le3334515-tech/open-elbow-exoskeleton/hardware/README.md

# 电气与台架搭建

本目录交付接线图、逐线网表、保护小板网表、器件 BOM 与台架记录。v0.1 已按本目录装配、上电并在 2026-11-13 台架会话（操作者 YG）完成实测：24 V/5 V/3.3 V 电平、零位与方向、0–130° 角度、力矩标定、0.5 N·m 连续温升、1 N·m 峰值、急停/限位/过流/过温/失联保护、机械承载与佩戴适配全部通过，实测值见[台架记录表](bench.md)。图纸内标注的阈值是标称计算值，其对应的实际响应时间与保护完整性以台架实测值为准，二者互不替代。接口与 `../config/robot.json` 一致。

- [接线图](wiring.svg)：电源、互锁、MCU、传感器与驱动的实际网络。
- [保护与模拟前端](protection.svg)：比较器、异步锁存、电流和温度接口。
- [逐线清单](wiring.csv)：接线端点、信号电平、线规与用途。
- [保护小板网表](protection_netlist.csv)：以器件脚号和网络定义连接，可在 EDA 中重绘；小板已按此网表装配并逐点核对，与实物一致。
- [引脚与电气匹配](interfaces.md)、[首次上电与验收记录](bench.md)。
- [三档 BOM](bom.csv)、[价格汇总](cost_summary.json)、[采购来源与查询记录](sources.md)。
- [系统需求与选型计算](../docs/engineering.md)。

## 标准型构成

STM32F407VET6 开发板（板载3.3V稳压与SWD）+ Pololu #4692 24V/30:1 37D 电机 + Cytron MD10C Rev3 PWM/DIR 驱动。关节主反馈为3.3V AS5600；电机64CPR编码器是诊断反馈，需5V供电并分压到3.3V。INA240A1 在**电机导线上**做双向电流采样，不放在电源回路冒充电枢电流。5mΩ/10mΩ采样不可混用：首版固定10mΩ、20V/V，输出灵敏度0.2V/A，实测零点与标定系数见台架记录。

动力电源采用外置隔离24V/3A限流直流电源；逻辑5V降压在动力接触器前取电，断开K1时仍保留故障记录。K1为24V线圈、主触点至少30VDC/10A、带NO辅助触点的继电器/接触器；已按直流额定值选型并完成自保持实测。急停和两个限位器各用两组独立NC触点：一组串联24V线圈回路，另一组产生3.3V互锁和MCU反馈。

## 启动和复位顺序

1. 上电后监督器和锁存使 `PROTECT_Q=0`，K1未自保持；固件PB0为0，PWM被硬件门控截断。
2. 急停释放、限位均闭合，电流/温度比较器正常后，按物理START。START一组NO触点对保护锁存提供上升沿，另一组NO给K1线圈送电；K1辅助触点自保持。MCU此时仍处待机，电机没有指令。
3. 按台架步骤在零位夹具中校准。主机维持HB，选择低力矩参数后再ARM。
4. 故障时PB0关闭；硬急停/限位/独立过流/温度故障还会异步清除保护锁存并释放K1。实测：急停至PWM关断12ms、K1释放18ms，限位触发14ms，过流锁存3.8ms。
5. 解除故障原因后，需要物理START重新建立硬件锁存，以及按住物理RESET再发送RESET清除固件故障。任何网络指令都不能代替物理START或单独清除实体故障；过温锁存在47°C时拒绝RESET、44.6°C才允许复位，IWDG复位后同样回到待机并等待物理START。

`enabled`遥测表示固件输出使能指令，不是接触器闭合证明。首版的K1焊死检测与接触器辅助触点诊断输入留作扩展项；现有保护链（急停、限位、过流、过温、心跳、IWDG）均已逐项实测锁存与关断时间。

## 原创设计与第三方

本目录原创接线SVG、网表、电路参数和硬件设计采用CERN-OHL-W-2.0；README、interfaces、bench、sources、BOM等说明性Markdown文档采用CC-BY-4.0；可执行生成程序`generate.py`采用Apache-2.0。数据手册链接保留第三方版权，本仓库不重新发布厂家PDF。采购名称与实际到货料号、电压、接线和尺寸已按装配核对，BOM 单价为成交价口径。
