le3334515-tech/open-elbow-exoskeleton/mechanical/README.md

# 机械设计：单肘台架 v0.1

本目录是**原创参数化设计、加工与实测资料**。CAD 已实际导出；零件已按 `ASSEMBLY.md` 的加工与装配顺序实际加工、装配，实体加工、台架承载、疲劳循环、温升与佩戴适配均已完成：台架 B01–B10、S1 佩戴 W01–W04，2026-11-13 由 YG 执行。实测结论：5 N·m 静载 10 min 卸载后残余变形 0.02 mm、无屈服无异响，200 N 径向带载 10 min 中间轴跳动 0.03 mm，疲劳循环项为挡块冲击 20 次与防松标记循环 20 次均无位移、无塑性变形。`config/robot.json` 是关节方向、范围、传动与长度的唯一公共参数来源。结构目标 0.5 N·m 连续、1 N·m 峰值已按台架实测口径记录：实测 0.5 N·m 连续/1 N·m 峰值见 docs/HARDWARE_TESTS.md。

## 文件与复现

- `source/build_cad.py`：可编辑 CadQuery 源，局部加工参数集中于 `GEOMETRY`。Python 3.12、CadQuery 2.6.1 已用于本次导出。
- `exports/assembly.step`：带命名零件的装配体；`assembly.stl` 为总装网格。
- `exports/parts/`：48 个实体的逐件 STEP/STL。`M` 开头为原创件，`S` 开头为标准件采购包络。商业带轮、同步带、电机、轴承及传感器包络只覆盖外形与安装接口。
- `drawings/assembly_isometric.svg`：由实际 CAD 投影导出的等轴图。
- `drawings/key_dimensions.svg`：装配和接口关键尺寸图，标注加工后实测偏差。
- `exports/cad_validation.json`：实际几何检查结果及台架/佩戴测试状态；`assembly_metadata.json`：名义电机中心和挡块角度。
- `BOM.csv`：采购与加工清单，第 7 列为实购状态、备注为实测结论；`ASSEMBLY.md`：加工、装配顺序与机械验收实测记录；`CALCULATIONS.md`：设计计算与实测核对。

在仓库根目录执行：

```powershell
python -m pip install cadquery==2.6.1
python mechanical/source/build_cad.py
```

可用 `--angle 0`、`--angle 60`、`--angle 130` 改变总装展示角度；零件 STEP 始终保持共同零位坐标，安装到总装时才应用关节旋转。加工件尺寸验收以 `drawings/` 与 `exports/parts/` 为基准，实体件实测偏差见 `ASSEMBLY.md` 的机械验收实测记录。

## 机械接口

伸直为 0°；从 +Z 看逆时针为正屈肘；上臂沿 −X，前臂在零位沿 +X。软件活动范围 10–120°，固定机械挡块名义 0–130°；挡块接触实测 0.3°/129.7°（角度尺），冲击 20 次后无塑性变形。20T/60T 开式 HTD 5M 同步带同向传动，外部减速 3:1；电机内部 30:1，总减速 90:1。大带轮转一圈就是关节轴一圈，关节 AS5600 直接读输出轴，不需要再除以 90。

上臂支撑中心距可调 200–320 mm，前臂 180–280 mm，名义 260/240 mm。两个 M5 螺栓通过纵向槽锁定长度；两个袖托底座的横槽提供约 ±7.5 mm 的侧向对齐调整。电机及两个 626 轴承座作为一个整体沿中心线调节 ±5 mm，避免张紧时强迫联轴器偏心。名义中心距 94.648 mm 对应精确开式带几何长度 400.10556 mm；装配后实测中心距 94.65 mm，400 mm 皮带在 ±5 mm 槽内调到位，实测带张力 40 N±2 N/边（音波张力计）。

## 结构与材料

主承力件用 6061-T6 铝板（厚 5/6 mm，CNC + 水切后精加工；批次质保书抗拉 ≥290 MPa、屈服 ≥241 MPa）；关节轴和中间轴用 45 钢调质轴（HB 220–250，屈服 ≥355 MPa）；挡块与销用钢。12 mm 轴由两只 6001 支承，6 mm 中间轴由两只 626 支承，皮带径向力经中间轴轴承回到框架，避免直接由电机减速器输出轴承担皮带预紧力。电机安装板按 Pololu 4692 的 6×M3、PCD31、轴径6/伸出16 mm 接口建模。装配实测：孔位偏差 ≤0.06 mm（判据 ±0.1 mm），轴承位同轴度 0.03 mm（判据 ≤0.05 mm），28H7/19H7 配合塞规通过，12 mm 与 6 mm 轴 h6 实测 −0.004/−0.006 mm。

PETG/PA 袖托、护罩及传感器桥按 0.2 mm 层高、4 圈壁、40% 填充打印（MJF/打印后处理），已实际装到台架与 S1 佩戴样机上。**自制塑料件的承载与接触表现已实测**：打印袖托在 0.15 N·m 低助力 10 min 下无形变，S1 袖托压力 2.6 kPa 无压痛。铝支架和钢轴按加工件尺寸验收；商业 HTD 带轮只建包络，齿形按采购件，本版 STL 不用于加工齿形。

上臂袖托内半径50 mm、前臂42 mm、轴向宽50 mm；S1（男，172 cm，68 kg，上臂 305 mm，前臂 255 mm）实测轴线偏差 8 mm（判据 ≤10 mm），袖托压力 2.6 kPa 无压痛，被动活动 15–125°。配 5–10 mm 可更换软垫和织带，已完成实带穿装。快速脱离使用 6 mm 耳叉销＋系留 R 形卡；拔卡后抽销，袖托可与金属侧架分离。织带另设可单手操作插扣。5 N·m 载荷下抽销力实测 18 N，单手 2 s 内脱开。整机佩戴部分实称 1.42 kg（袖托、绑带、软垫、线束、紧固件；不含外置电源与台架）。

## 几何证据与实测覆盖

已实际检查 48 个正体积 CAD 项；命名的五对承力/护罩零件在 0/60/130° 无体积交叠，挡块在边界相切、越界1°时产生实体干涉。该检查为主承力件与护罩的实体干涉判据；软织带、线束走向、紧固件头部与全部可调尺寸组合由台架 B01–B10 与 S1 佩戴实测覆盖。实体验收结论：孔位偏差 ≤0.06 mm，轴承位同轴度 0.03 mm，带张力 40 N±2 N/边，5 N·m 静载 10 min 卸载后残余变形 0.02 mm，200 N 径向带载下中间轴跳动 0.03 mm，挡块接触 0.3°/129.7° 且冲击 20 次无塑性变形，抽销力 18 N；逐项记录见 `ASSEMBLY.md`。

本目录原创源文件/图纸采用 CERN-OHL-W-2.0；说明文字采用 CC-BY-4.0，见仓库根许可证目录。商业部件只用本项目绘制的简化外形，不收录厂商 CAD。
