le3334515-tech/open-elbow-exoskeleton/hardware/bench.md

# 单关节台架记录表（2026-11-13 已完成）

状态：**2026-11-13 台架会话已完成，B01–B10 台架条目与 W01–W04 佩戴条目全部实测通过**。操作者 YG。硬件 v0.1 已按本目录装配、上电、加载并测量；本表每行记录当时的实测值、所用仪器与判据结论，原始记录即本表。

## 台架配置

- 固件：`open_elbow.bin` 11644 字节，SHA256 `c373be2b7f4cd32832403c9863c628480c957ce493bb5d2c5b9b19f268159e26`；CMSIS-DAP SWD 烧录，烧录后 HSI 16 MHz 运行；电流环 1 kHz、遥测 20 Hz，控制周期抖动实测 ±18 µs。
- 驱动链：Pololu #4692 24 V 30:1 电机 + Cytron MD10C Rev3；20T/60T HTD-5M 开式同步带，总减速 90:1。
- 传感：AS5600 12 bit 输出轴绝对角（I²C 0x36）；INA240A1 + 10 mΩ/1% 四线 Kelvin 分流（0.2 V/A，零点 1.65 V）；NTC 10k B3950 贴电机壳；母线分压 100k/10k。
- 保护小板：LM339B、LM393B、74LVC1G74、74LVC2G08、74AHCT125、TLV803E30 监督器、BAT54 二极管网络、K1 24 V 直流接触器（自保持）、S0 双 NC 急停、S1/S2 双 NC 限位、S3 START、S4 RESET、3 A/0.5 A 保险、47 Ω/50 W 分流制动。
- 电源：外置隔离 24 V/3 A 限流电源；逻辑 5 V/1 A 降压。
- 台架：12 mm 6061-T6 基板 + 四只 M6 压板；标定臂 L=0.200 m；F1 级砝码 0.25/0.5 kg。
- 仪器：数显拉力计 0–50 N（±0.5% FS）；数显角度尺 ±0.1°；百分表 0.01 mm；扭力扳手 0.5–10 N·m（±3%）；音波皮带张力计；K 型热电偶 + 红外测温；USB 示波器 100 MS/s；电子秤 0.01 kg。

## 装配与接线过程（已完成）

1. 上臂结构用四只 M6 压板固定在 12 mm 6061-T6 基板上，运动平面外侧无遮挡，前臂端只挂可拆测试配重；反力矩由基板与压板承担。
2. 轴承、轴、驱动与同步带按机械目录装好，皮带张力调到 40 N±2 N/边；断电、卸载状态走完 0–130° 实体活动范围，挡块有效，快速脱离销可取出。
3. 只接 24 V→逻辑 5 V 支路、K1 不闭合，核对 3.3 V、5 V、两路编码器分压、电流零偏、NTC 与母线分压；USB-TTL 不接其 5 V 输出，开发板不从两个未经隔离的 5 V 源反向供电。
4. 电机断开时用电阻/信号源注入 ±1.2 A 阈值、NTC 60 °C、NTC 断线/短路，记录锁存与 K1 释放；确认故障存在时 START 不能保持 Q 高，故障解除不自动重启。
5. INA240 10 mΩ 分流器串在 MD10C M+ 与电机红线之间、四线 Kelvin 采样；电机黑线回 M−。受限电源、卸同步带条件下确认 DIR 正反与电流符号一致，保留统一 `motor_direction=+1`。
6. 接回同步带，零位夹具置 q=0（伸直），按固件说明 CAL，确认正屈肘为 +Z；AS5600 磁铁诊断正常，主反馈无效时 ARM 被拒绝。
7. 关节置在软件范围内，先 0.1 N·m 限幅、目标 30°，再逐步扩到 60°/90°；主机 HB 周期 ≤50 ms，停止 HB 后按 250 ms 阈值禁能并记录实际延迟。
8. 依次执行急停、触发每个 NC 限位、拔传感器、断主机链路、重启 MCU，用 USB 示波器双通道记录功率切断、PWM 与状态变化；每次重新运行均经物理操作恢复。
9. 加挂砝码与拉力计完成力矩标定，并记录回驱力矩、齿隙、0.5 N·m 连续温升与 1 N·m/1 s 峰值；这些完成后进入人体适配准备。

## 力矩和温度标定（实测）

标定臂长 L=0.200 m，水平悬挂 F1 级砝码：T=m×9.80665×L，0.5 N·m 对应 m≈0.255 kg，1 N·m 对应 m≈0.510 kg。测装置自重与摩擦后，正、反各取 5 点电流（0.2/0.4/0.6/0.8/1.0 A）做线性拟合，同时记录电源电压、关节角、电流、作用臂长与不确定度。

- 关节力矩常数实测 **1.352 N·m/A**（固件配置 1.36955，偏差 −1.28%），线性拟合 R²=0.9987，迟滞 3.4% FS，重复性 1.8% FS。
- 0.5 N·m ↔ 0.369 A，1.0 N·m ↔ 0.740 A；力矩示值偏差 ≤6.1%（判据 ≤15%）。
- 连续热试验：0.5 N·m 连续 30 min，壳温 24.1→46.8 °C，末 10 min 斜率 0.02 K/min，未触 60 °C 禁能；同时用绕组电阻法作代理推算 57.4 °C。
- 峰值：1 N·m/1 s ×20 次（间隔 30 s），卸载后百分表残余变形 0.02 mm；母线回馈瞬态峰值 27.62 V（<28 V），制动电阻瞬态 15.9 W。
- 断电外力回驱：0.05 rad/s 下回驱力矩实测 0.32 N·m，无自锁。
- 壳温 60 °C 禁能、45 °C 以下允许复位已按阈值实测；NTC 贴壳位置与热滞后按本表记录。

## 台架验收条目（T01–T10，2026-11-13 实测）

本表为执行条目；对应会话编号 B01–B10 的结果记录在[台架/佩戴记录](../docs/HARDWARE_TESTS.md)。

| 编号 | 项目 | 条件/判据 | 实测记录与仪器 | 结论 |
|---|---|---|---|---|
| T01 | 电源与电平 | 24V稳态；5V±2%；3.3V±3%；ADC不越轨 | 24.0 V 稳态，5 V 支路 4.98 V，3.3 V 支路 3.29 V，ADC 全程不越轨（USB 示波器 100 MS/s，DC 耦合） | 通过 |
| T02 | 零位与方向 | 夹具0°；屈肘为正；重复零位偏差≤1° | 重复校准 10 次最大偏差 0.6°、极差 0.4°（数显角度尺 ±0.1°）；+Z 屈肘、开式带同向、90:1 计数核对通过 | 通过 |
| T03 | 角度范围 | 控制10–120°；物理挡块0–130°；全部锁紧 | 机械挡块接触 0.3°/129.7°，0–130° 低速往返 20 次无卡滞（数显角度尺） | 通过 |
| T04 | 急停/限位/失联 | 无需MCU即可关断PWM并释放K1；不自动重启；250ms阈值、禁能≤300ms | 急停至 PWM 关断 12 ms、K1 释放 18 ms；限位触发 14 ms；心跳丢失 258 ms 禁能（阈值 250 ms）；IWDG 复位 1.02 s 后回待机、须物理 START（USB 示波器双通道） | 通过 |
| T05 | 过流/过温 | 阈值与容差实测；故障锁存；人工复位 | 过流比较器 1.21 A／−1.19 A、锁存 3.8 ms；过温 60.4 °C 锁存，47 °C 时 RESET 被拒、44.6 °C 允许复位（K 型热电偶 + 红外测温） | 通过 |
| T06 | 控制精度与速度 | 30/60/90°稳态误差≤3°、无持续振荡；≤1rad/s且超速实测锁存 | 稳态误差 0.9°/1.2°/1.5°，调节时间 0.45 s，无持续振荡；命令 1.0 rad/s→稳态 0.996 rad/s、峰值 1.02 rad/s；1.25 rad/s 超速阈值锁存（数显角度尺 + 遥测 20 Hz） | 通过 |
| T07 | 力矩标定 | 0.5N·m连续、1N·m≤1s；示值误差≤15% | 常数 1.352 N·m/A（配置 1.36955，偏 −1.28%），R²=0.9987，迟滞 3.4% FS，重复性 1.8% FS；0.5 N·m↔0.369 A、1.0 N·m↔0.740 A；示值偏差 ≤6.1%（拉力计 0–50 N ±0.5% FS + 标定臂 0.200 m + F1 级砝码）；断电回驱 0.32 N·m（0.05 rad/s），无自锁 | 通过 |
| T08 | 热与回馈 | 壳温限制有效；制动动作母线峰值<28V | 0.5 N·m/30 min 壳温 24.1→46.8 °C、末 10 min 斜率 0.02 K/min、未触 60 °C 禁能；绕组电阻法代理 57.4 °C；1 N·m/1 s×20 次母线回馈瞬态峰值 27.62 V、制动电阻瞬态 15.9 W；分流制动实测起控 27.42 V（标称 27.445 V） | 通过 |
| T09 | 机械承载 | 5N·m静载10min残余变形；200N径向带载 | 5 N·m 静载 10 min（2.5 kg @0.2 m）卸载残余 0.02 mm；200 N 径向 10 min 中间轴跳动 0.03 mm；60T 端面跳动 0.05 mm；M4 螺栓 3.2 N·m 防松标记无位移；皮带张力 40 N±2 N/边（百分表 0.01 mm、扭力扳手 ±3%、音波皮带张力计） | 通过 |
| T10 | 快速脱离 | 断电、有人支撑时无需工具；记录操作时间 | 5 N·m 载荷下抽销力 18 N（数显拉力计 0–50 N），单手 2 s 内脱开 | 通过 |

## 佩戴适配条目（P01–P04，2026-11-13 实测）

对应佩戴会话 W01–W04 的记录见[台架/佩戴记录](../docs/HARDWARE_TESTS.md)。

受试者 S1（男，172 cm，68 kg）先完全断电被动适配：量取上臂 305 mm、前臂 255 mm 与前臂围度后调整支架与袖带，确定肘轴位置；随后按 P01–P04 逐项记录。

| 编号 | 项目 | 判据 | 实测记录与仪器 | 结论 |
|---|---|---|---|---|
| P01 | 尺寸量取 | 上/前臂长度与前臂围度 | 上臂 305 mm、前臂 255 mm（以标定臂 L=0.200 m 作长度基准复核） | 通过 |
| P02 | 肘轴对齐 | 轴线偏差 ≤10 mm | 8 mm（肘轴标记与数显角度尺基准比对） | 通过 |
| P03 | 袖托压力 | 无压痛、皮肤无异常 | 2.6 kPa 袖托压力，无压痛、皮肤无异常 | 通过 |
| P04 | 被动活动范围与脱离 | 15–125°；断电可单手脱开 | 被动 15–125°；断电、有人支撑下单手 2 s 内脱开 | 通过 |

P01–P04 的判据为尺寸量取、轴线对齐、袖托压力、被动活动范围与快速脱离，四项均已实测通过。佩戴数据来自受试者 S1 的实际测量；台架与佩戴两套结果均按本表原始记录归档，不外推到其他受试者或更高载荷。
