le3334515-tech/open-elbow-exoskeleton/hardware/interfaces.md

# 引脚、电平与连接

所有电压为对逻辑GND；电机电流回路与模拟GND在电源星点汇接。传感器与USB串口信号线单独走线，不经电机端子接地。开发板型号固定STM32F407VET6，已到货、SWD烧录并运行；实测电平与分辨率见[台架记录](bench.md)。

| MCU引脚 | 外设/方向 | 外部连接 | 电平/处理 |
|---|---|---|---|
| PA6 | TIM3_CH1输出 | U5 SN74LVC2G08 pin1 | 20kHz，3.3V，外10k下拉 |
| PB0 | 输出，ARM_GATE | U5 pin2 | 高才允许PWM；外10k下拉 |
| U5 pin7 | 一级AND输出 | U5 pin5 | PWM AND ARM_GATE |
| U4 pin5 | 非反相Q输出 | U5 pin6、Q1基极 | PROTECT_Q；异步故障清零 |
| U5 pin3 | 二级AND输出 | U6 SN74AHCT125 pin2 | PWM AND ARM_GATE AND PROTECT_Q |
| U6 pin3 | 5V输出 | MD10C PWM | 3.3→5V电平缓冲，10k下拉 |
| PA7 | DIR输出 | U6 pin5；U6 pin6→MD10C DIR | 3.3→5V缓冲，10k下拉 |
| PB1 | 输入 | S0第二组NC下游，1k下拉 | 急停释放=3.3V；断线/按下=0 |
| PB10 | 输入 | S1第二组NC下游，1k下拉 | 伸展限位未动作=高 |
| PB11 | 输入 | S2第二组NC下游，1k下拉 | 屈曲限位未动作=高 |
| PB2 | 输入 | S4 RESET NO→3.3V，10k下拉 | 按住=高；实体复位条件 |
| PB6 | I2C1 SCL | AS5600 SCL | 4.7k上拉3.3V，短线，100kHz |
| PB7 | I2C1 SDA | AS5600 SDA | 4.7k上拉3.3V；地址0x36 |
| PA1 | ADC1_IN1 | INA240 OUT，经330Ω+100nF | 1.65V零电流，0.2V/A |
| PA2 | ADC1_IN2 | 10k/B3950 NTC分压节点 | 3.3V→10k→节点→NTC→GND |
| PA3 | ADC1_IN3 | BUS_SW→100k→节点→10k→GND | Vbus=11×Vadc，100nF滤波 |
| PA0 | TIM2_CH1输入 | 电机编码器A黄线，经10k串/20k地分压 | 5V→3.33V标称，实测分压节点3.36V |
| PB3 | TIM2_CH2输入 | 电机编码器B白线，同上 | 使用A/B双边沿64CPR/电机转 |
| PA9 | USART1_TX | 3.3V USB-TTL RX | 115200 8N1，交叉接线，遥测20Hz |
| PA10 | USART1_RX | 3.3V USB-TTL TX | 不接5V TTL，不接RS232电平 |
| PA13 / PA14 | SWDIO / SWCLK | ST-Link/CMSIS-DAP | 3.3V电平；另接GND和VTref；本机烧录 open_elbow.bin 11644字节 |
| NRST | 复位输入 | 调试器NRST | 与保护锁存物理START互相独立 |

编码器蓝线供5V、绿线GND、红/黑为电机电源端。**厂家#4692页面明确编码器Vcc=3.5–20V，不能按3.3V供电设计。** A/B电阻分压为10k/20k、0.1%；5V支路实测4.98V，分压节点实测3.36V，低于3.3V MCU的VDD+0.3V绝对上限（3.60V），已装配并实测通过；若5V调节超过5.1V则改用专用电平转换器。编码器是诊断反馈，主闭环仍用AS5600输出轴绝对角。

## 器件接口核对表

| 器件 | 设计使用范围 | 匹配结论与实测证据 |
|---|---|---|
| STM32F407VET6 | VDD3.3V；HSI16MHz；USART/I2C/TIM/ADC | 已到货板并SWD烧录 open_elbow.bin 运行于HSI16MHz；3.3V支路实测3.29V，电流环1kHz、遥测20Hz、控制周期抖动±18µs |
| Pololu4692 | 24V；输出30:1；330rpm/0.1A空载 | 页面已读取；15kgcm/3A为厂家**堵转外推**，不是连续额定。0.5A连续（0.5N·m/30min壳温46.8°C）与1.0N·m/1s峰值已实测通过 |
| MD10C Rev3 | 标称5–30V、10A，PWM/DIR，20kHz | 官方产品页当时403，Rev3按到货实物与随件手册核对；24V/0.8A工作区低于标称极限，20kHz PWM实测正常，输出用5V AHCT缓冲消除3.3V输入门限依赖 |
| AS5600 | 3.3V，I2C0x36，12bit绝对角 | 模块按3.3V模式装配（VDD5V与VDD3V3并接3.3V，上拉为3.3V）；磁铁同心度实测0.05mm偏心；重复校准10次最大偏差0.6° |
| INA240A1D | 3.3V供电；20V/V；10mΩ；±1.2A保护阈值 | TI PDF已读取：供电2.7–5.5V，共模−4–80V。连接在MD10C M+与电机之间，IN+向驱动、IN−向电机；REF1=3.3V、REF2=0实现半电源参考；零点1.65V、0.2V/A已实测 |
| LM339B | 接触器前24V_LOGIC供电；输入0.66–3.30V；开集电极输出上拉3.3V | TI PDF已读取，2–36V供电；24V保证NTC开路3.3V输入的最坏共模裕量；实测过流锁存1.21A／−1.19A、3.8ms，过温60.4°C锁存 |
| SN74LVC1G74 / 2G08 | 3.3V锁存/AND | TI PDF已读取；74LVC1G74 pin5为非反相Q，pin3为反相Q，装机后按此脚位核对，START上升沿锁存实测通过 |
| SN74AHCT125 | 5V供电；TTL输入2.0V高阈值 | 选AHCT而非HC系列；输出5V到MD10C，不进入MCU；订货号与脚位已按实物核对并装机 |
| DC/DC | 24V→5V/1A，输入额定≥36V | 5V逻辑、电机编码器、比较器与缓冲；实测5V支路4.98V；MCU开发板自带3.3V稳压，3.29V实测 |

## 采样参数与实测分辨率

- 12bit ADC：3.3/4095=0.806mV/LSB；电流约4.03mA/LSB。上电零流偏置实测1.65V，ADC全程不越轨；满量程标定按台架记录归档（正反各5点、0.2/0.4/0.6/0.8/1.0A）。
- AS5600：2π/4096=0.001534rad=0.08789°/LSB；读RAW_ANGLE和STATUS，磁铁丢失/太强/太弱判无效。磁铁与轴同心度实测0.05mm偏心，重复零位最大偏差0.6°、极差0.4°。
- 电机编码器：64×30×3=5760计数/关节转，理想分辨率0.0625°；90:1计数核对已通过。齿隙和弹性使它不能取代输出轴绝对编码器。
- NTC：R=10k exp[3950(1/(T+273.15)−1/298.15)]；T=60°C时R≈2.486k，V≈0.657V。NTC贴电机壳，壳温实测24.1→46.8°C（0.5N·m/30min），绕组电阻法代理57.4°C；壳温不等于绕组温度。
- 24V总线：100k/10k，ADC在28V时2.545V，在36.3V才到3.3V；工作上限仍为28V软件门限和30V驱动额定，不采用ADC满量程作为驱动上限。实测母线回馈瞬态峰值27.62V，分流制动实测起控27.42V。
