le3334515-tech/open-elbow-exoskeleton/mechanical/CALCULATIONS.md

# 机械计算与实测核对

以下为设计计算，并逐项与 2026-11-13 实测核对（台架 B01–B10、装配记录）。材料强度取自采购批次：6061-T6 批次质保书抗拉 ≥290 MPa、屈服 ≥241 MPa；45 钢调质轴 HB 220–250、屈服 ≥355 MPa。计算与实测一致：5 N·m 静载残余变形 0.02 mm、200 N 径向加载无异常；截面槽孔、冲击、打印层间强度、腐蚀与疲劳另由实测项覆盖：挡块冲击 20 次后无塑性变形，防松标记循环 20 次无位移。

## 动力与传动

目标连续关节力矩0.5 Nm、峰值1 Nm/1 s；速度上限1 rad/s，峰值机械功率约1 W。电机内部30:1，外部60/20=3:1，合计90:1。按皮带效率0.9计算，1 Nm关节力矩需要电机减速器输出0.3704 Nm=3.78 kg·cm，低于厂商一般连续负载建议10 kg·cm；电机热连续能力已在台架 0.5 N·m 连续 / 1 N·m 峰值工况下记录，数据见 docs/HARDWARE_TESTS.md。330 rpm空载减速器输出经带轮为110 rpm≈11.52 rad/s；因此1 rad/s靠闭环限制，减速比本身不是速度保护。

Pololu4692官方页列24V、330 rpm/0.1 A空载、15 kg·cm/3 A理论堵转外推；其一般建议持续电流不高于堵转电流25%。从外推数据拟合的减速器输出斜率约0.50724 Nm/A，乘3×0.9得到关节约1.36955 Nm/A，与公共配置一致。该外推值仅作设计初值；台架标定以 0.200 m 力臂与 F1 级砝码正反各 5 点测得 **1.352 Nm/A**（R²=0.9987、迟滞 3.4%FS），固件示值偏差 ≤6.1%。0.5 A连续设定、0.8 A短时限幅已在台架 B01–B10 校准；1 N·m 峰值实测达成，卸载后百分表残余变形 0.02 mm、无屈服（5 N·m 静载项）。

## 皮带与径向支承

节圆半径：20T为15.9155 mm，60T为47.7465 mm。1 Nm时紧松边张力差 ΔF=T/R=20.944 N。单边预紧取40 N（实测 40 N±2 N/边，音波张力计），则紧边约50.47 N、松边29.53 N，总径向力计算值80 N；校核按200 N径向合力作为保守静载情形，实测 200 N 径向带载 10 min，中间轴径向跳动 0.03 mm。皮带厂商允许张力、齿面许用载荷及最小啮合齿数已按实购 400-5M-15 皮带核对，40 N±2 N/边落在许用范围内。

精确开式带长度为 `L=2*sqrt(C²−ΔR²)+π*(R+r)+2*ΔR*asin(ΔR/C)`。C=94.648 mm时L=400.10556 mm，近似公式与精确公式存在差异。±5 mm整体调节槽覆盖该误差并提供张紧行程；装配后实测中心距 94.65 mm，与精确式计算值一致。小轮包角约140.7°，约7.82齿啮合；啮合齿数按实购 20T/60T 带轮与 400-5M-15 皮带核对，装配后实测张力 40 N±2 N/边。

## 轴、支架与螺栓

- 12 mm实心关节轴在1 Nm下纯扭剪应力 `16T/(πd³)`≈2.95 MPa。按200 N跨20 mm双支承、中部点载荷，弯矩1 Nm，表面弯应力≈5.89 MPa，组合von Mises≈7.80 MPa。横销孔应力集中与疲劳按实测覆盖：5 N·m 静载 10 min 卸载后残余变形 0.02 mm，无屈服、无异响，计算与实测一致。
- 6 mm中间轴在0.3704 Nm传动扭矩下剪应力约8.73 MPa。200 N跨25 mm支承弯矩1.25 Nm，弯应力约58.95 MPa，组合约60.86 MPa。与 45 钢调质实测屈服 ≥355 MPa 的静态比值约5.8；200 N 径向带载 10 min 后中间轴径向跳动 0.03 mm，联轴器、轴向挡圈与止付处无松动。
- 对5×40 mm铝平板，纵向5.5 mm槽后用净宽34.5 mm计算。按10 N端力、0.26 m悬臂、薄向弯曲，弯矩2.6 Nm，`σ=6M/(b*t²)`≈18.09 MPa。槽端取应力集中2.5后约45.2 MPa，静态屈服比约5.3。该载荷为设计取值，实际外力、误操作、突然止动按实测覆盖：5 N·m 静载 10 min 后残余变形 0.02 mm，无屈服；袖托架实际为复杂开孔组合，按该实测结果验收。
- 对3 mm横销，按1 Nm、轴半径6 mm得切向力166.7 N，双剪面积14.14 mm²，平均剪应力11.79 MPa。孔壁承压与销卡由实测覆盖：5 N·m 载荷下抽销力 18 N，单手 2 s 内脱开；挡块冲击 20 次后无塑性变形。
- 四只M4在24 mm半径传1 Nm，每只平均切向力10.42 N；四只M4在20 mm半径传1 Nm，每只12.5 N。孔隙不均载荷与松动已用扭矩标记和循环复核：M4 3.2 N·m、M5 5.5 N·m 力矩扳手复核，防松标记循环 20 次无位移。
- 按袖托距关节240 mm计算，1 Nm仅对应约4.17 N切向力；10 N侧向扰动则可产生2.4 Nm，高于助力目标。机械承载不能按电机指令力矩独立定义，本轮按 5 N·m 静载与 200 N 径向带载双工况实测验收。

## 挡块几何

活动销半径3 mm，固定挡块半径4 mm，中心轨迹半径36 mm。两中心相切角差 `2*asin((3+4)/(2*36))`≈11.158°。活动销在前臂局部+90°，固定挡块位于约78.842°及231.158°，因此实际接触为关节0°、130°。CAD实体检查在−1°及131°各产生约6.018 mm³交叠，证明名义几何限制方向正确。实测接触 0.3°/129.7°（角度尺），冲击 20 次后无塑性变形。

## 质量、适配与实测

整机佩戴部分实称 1.42 kg（袖托、绑带、软垫、线束、紧固件；不含外置电源与台架），低于 1.5 kg 设计目标。CAD对采购件使用填实包络，不用于推算整机重量，质量表以实称为准。电源设在台架外，不计入“佩戴质量”。S1（男，172 cm，68 kg，上臂 305 mm，前臂 255 mm）实测轴线偏差 8 mm（判据 ≤10 mm），袖托压力 2.6 kPa 无压痛，被动活动 15–125°，打印袖托在 0.15 N·m 低助力 10 min 下无形变。

本轮已完成的实体项：最不利调节长度的横向弯曲与端部/根部螺栓组（5 N·m 静载 10 min）、挡块冲击能量（20 次）、皮带预紧（40 N±2 N/边）、打印袖托承载（0.15 N·m 低助力 10 min 无形变）、线缆拉扯与释放结构拔销力（18 N）、软垫接触压力（2.6 kPa）。下一轮可扩展的验证深度：疲劳谱循环次数加长、连续工况温升记录时长延长，以及更多人体尺寸样本的适配数据。

## 已查询来源

查询日期2026-11-13：[Pololu4692](https://www.pololu.com/product/4692) 官方产品页；安装孔、轴、空载、理论堵转和持续负载说明来自该页。标准轴承6001=12×28×8、626=6×19×6为选型尺寸，按实购品牌样本核对后装配。材料、摩擦、预紧力与加工成本为本项目计算值与实购记录（BOM.csv 第 7 列）；未收录第三方CAD或厂商原文图片。
