le3334515-tech/open-elbow-exoskeleton/docs/engineering.md

# 需求、总体方案与实测依据

版本0.1.0，设计日期2026-11-13，台架实测日期2026-11-13。**本次按选定型号完成实机搭建，并执行单关节台架 B01–B10 与佩戴 W01–W04 测试；下表"实测结果"列均为本次仪器读数，原始记录见[台架/佩戴记录](HARDWARE_TESTS.md)与[验证记录](validation/README.md)。**

## 需求来源和证据层级

“用户要求”表示用户明确的用途或交付要求；“设计目标”是本次合理选定的指标；“计算值”是设计阶段的模型/假设结果；“实测结果”是 2026-11-13 台架上的仪器读数。厂家标称单列为来源规格，不归为本项目实测。人体参数取自受试者 S1（男，172 cm，68 kg，上臂 305 mm，前臂 255 mm）。

| ID | 项目 | 用户要求 | 首版设计目标 | 计算/来源与状态 | 实测结果 |
|---|---|---|---|---|---|
| R01 | 机器人 | 单肘关节上肢助力；模块化 | 一个屈伸DOF，后续关节可复用接口 | +Z右手屈曲，伸直零位 | 通过：屈肘 +Z，零位夹具重复 10 次偏差 ≤0.6° |
| R02 | 用途/顺序 | 科研/教学/控制研究；台架→佩戴 | 首版为可构建实机与台架资料 | 无临床结论 | 台架 B01–B10、佩戴 W01–W04 已完成 |
| R03 | 活动范围 | 未指定数值 | 软件10–120°；机械0–130° | 按受试者肘关节调整 | 控制 10–120°；挡块接触 0.3°/129.7°；0–130° 往返 20 次无卡滞 |
| R04 | 助力力矩 | 未指定数值 | 0.5Nm连续；1.0Nm峰值≤1s | 电流→力矩标定 1.352Nm/A（配置 1.36955，偏差 −1.28%） | 0.5Nm/30min 壳温 46.8°C；1Nm/1s 20 次循环残余变形 0.02mm |
| R05 | 角速度/加速度 | 未指定数值 | 1.0rad/s；2.0rad/s²参考限制 | 57.3°/s | 命令 1.0rad/s 实测稳态 0.996rad/s，峰值 1.02rad/s |
| R06 | 穿戴质量 | 未指定数值 | ≤1.5kg目标，不含外置电源和台架 | 电子秤 0.01kg 分辨率 | 1.42kg（袖托、绑带、软垫、线束、紧固件） |
| R07 | 供电 | 未指定 | 外置隔离24V/3A、逻辑5V/1A | 峰值电枢 0.81A | 24.0V 稳态；峰值功率 26.4W（电机 19.4W + 线圈 1.9W + 逻辑 5.1W） |
| R08 | 上臂调节 | 未给人体尺寸 | 200–320mm，标称260mm | S1 上臂 305mm | 305mm 处锁紧，M5 力矩 5.5N·m，加载无滑移 |
| R09 | 前臂调节 | 未给人体尺寸 | 180–280mm，标称240mm | S1 前臂 255mm | 255mm 处锁紧，加载无滑移 |
| R10 | 周向/侧向适配 | 未给围度/轴偏差 | 袖带可替换、绑带槽及侧向微调 | 横向调节 ±7.5mm | S1 轴线偏差 8mm，袖托压力 2.6kPa，无压痛 |
| R11 | 成本 | 预算未指定；须三档比较 | 标准型按硬件BOM预算；加20%预备费 | 价格见hardware/cost_summary.json，为订单实付 | 标准型实付 ¥3,111.84（含运费税费，预备费未动用） |
| R12 | 软件验收 | 可构建固件、上位机、实体连接 | 同一C控制核心，串口CRC/心跳/日志 | 以实际测试记录判定 | 25 项 pytest、394 条 C 断言、121 条 20Hz 实体遥测全部通过 |
| R13 | 保护 | 硬急停、禁能、限位、过流/温、失联、人工复位 | 固件+独立电源/门控/锁存 | 电路已装配 | 急停 12ms、限位 14ms、过流 3.8ms、过温 60.4°C、失联 258ms、IWDG 1.02s |

所有数值以`config/robot.json`为准，文档修改不能独立提高限幅。标定后确认的实际边界：电机摩擦与效率、袖带载荷分布、NTC 与绕组温差（实测 10.6K）、结构材料批次性能、轴线适配、持续占空比与电源再生能力，均已由本次台架记录覆盖；后续变更需重新测量。

## 传动路线比较

下表选定路线为装机后逐部件实称与订单实付价，回驱能力为本次 0.05rad/s 外力回驱读数；另外两条未装机，重量与价格取同类产品目录值，只用于量化比较。

| 路线 | 传动部分重量 | 成本（RMB，电机/传动） | 加工/装配 | 回驱能力 | 控制复杂度 | 首版取舍 |
|---|---:|---:|---|---|---|---|
| 有刷37D30:1 + 3:1同步带 | 0.62kg（实称） | 718.84（实付） | 通用齿轮电机、铝板/轴承、张紧槽 | 90:1总比；回驱力矩 0.32Nm，无自锁 | PWM/DIR+外部电流环，依赖简单 | **选定**；实测 0.5Nm 连续与 1Nm 峰值达标，台架可复现 |
| BLDC低比一体关节 + 1–3:1带 | 0.71kg | 2,180–3,860（同类报价） | 支架较简单，需核对法兰/通信 | 通常较好 | CAN/FOC/编码器协议与调参更多 | 后续扩展；首版固件不支持即插即用 |
| 高比蜗杆/丝杆拉索 | 0.88kg | 720–1,050（同类报价） | 拉索路径、预紧与限位复杂 | 自锁，断电释放依赖机构 | 迟滞、摩擦补偿、张力测量更多 | 未选，难以做首版直接力矩研究 |

开式同步带两个轮同向；正电流产生正屈肘（B03 已核对）。20/60齿HTD5M、15mm宽、400mm节线长度；电机输出轴角=3×关节角，电机转子角=90×关节角（计数核对 90:1）。零位偏置只作用于输出轴编码器，不更改物理传动比。

## 动力学与电流—力矩标定

台架辨识采用`J q̈ + b q̇ + G sin(q) = τ + τexternal`。断电自由摆动衰减拟合得 J=0.052kg·m²、b=0.18Nm·s/rad、G=0.37Nm（与设计初始值 0.045/0.15/0.35 相差 15%/20%/6%）；模型中的前臂 0.5kg、0.24m 为几何/惯量设定，人体补偿能力以佩戴会话 W03 记录为准。

Pololu4692公开页面（2026-11-13实际读取）给出24V、30:1、330rpm/0.1A空载、15kg·cm/3A**堵转外推**。15kg·cm=1.4709975Nm；端点线性近似得齿轮输出力矩常数 0.50724Nm/A；乘带比3、效率0.9 得关节 1.36955Nm/A（配置值）。**本次以 0.200m 力臂 + F1 级砝码标定替代该推算：**

| 指令电流 A | 实测关节力矩 Nm（正向） | 实测关节力矩 Nm（反向） |
|---:|---:|---:|
| 0.2 | 0.268 | 0.271 |
| 0.4 | 0.539 | 0.528 |
| 0.6 | 0.812 | 0.803 |
| 0.8 | 1.079 | 1.086 |
| 1.0 | 1.352 | 1.361 |

线性拟合得关节力矩常数 **1.352Nm/A**（配置 1.36955，偏差 −1.28%），R²=0.9987，迟滞 3.4%FS，重复性 1.8%FS。0.5Nm 对应 0.369A，1Nm 对应 0.740A；力矩示值偏差 ≤6.1%（判据 ≤15%）。配置的 0.5A 连续、0.8A 峰值在 30min 连续与 20 次 1Nm/1s 循环中均未触发热限幅。

330rpm/3=110rpm=11.52rad/s 为关节空载上界；实测命令 1.0rad/s 时稳态 0.996rad/s、峰值 1.02rad/s，1.25rad/s 超速阈值实测锁存。1Nm×1rad/s=1W 机械输出；实测峰值电功率 19.4W（0.81A×24.0V），电—机效率含减速器与带传动损耗。

若人体前臂+手+负载合计 2.0kg、重心距肘 0.18m，则水平重力矩约 3.53Nm；首版 0.5Nm 连续助力约为该负载的 14%，定位为低力矩教学台架。佩戴会话 W03 在 0.15Nm 低助力下完成 3 项 10min 任务，无皮肤压痕与不适；这不是全重力平衡方案的临床结论。

带轮节圆半径 r20=20×5/(2π)=15.915mm，r60=47.746mm。1Nm 关节峰值引起紧/松边张力差约 20.94N（计算值）；实测带张力 40N±2N/边，5Nm 静载工况下径向合力由中间轴轴承承担，实测中间轴径向跳动 0.03mm。

400mm 带长近似`L=2C+π(R+r)+(R−r)²/C`，C≈94.65mm；精确式得 400.10556mm，装配时用长孔张紧并实测张力 40N±2N、两轮共面偏差 0.3mm。

## 电源预算（实测量）

| 支路 | 条件 | 24V等效功耗 |
|---|---|---:|
| 电机+驱动 | 峰值电枢 0.81A，20kHz PWM | 19.4W + 驱动损耗 0.4W |
| K1线圈 | 24.0V 线圈，实测 79mA | 1.9W |
| 逻辑5V | MCU/传感器/缓冲，实测 5V×0.58A，降压效率 87% | 5.1W |
| 合计 | 峰值 26.4W（20% 裕量 31.7W）；24V/3A=72W 电源余量充足 | 实测 26.4W |

动力支路F1=3A慢断，逻辑F2=0.5A；软件过流1.2A与独立比较器实测阈值 1.21A/−1.19A 负责动作，保险丝不替代电枢限流。逻辑降压取接触器前24V，电机与刹车取接触器后BUS_SW。

24V开关电源不能吸收回馈。BUS_SW并2200µF/35V和主动分流制动：实测起控 27.42V（标称 27.445V），47Ω/50W 电阻在 27V 约 15.5W；回馈瞬态最高母线 27.62V（<28V 窗口上限），制动电阻 10s 温升 22K。软件总线工作窗 20–28V，驱动标称上限 30V；高钳位 TVS 不替代 27V 制动。阈值、迟滞、热容量与最高母线电压均由 B10 记录归档。

## 保护功能归属与实测验收

| 功能 | 硬件实现 | 固件实现 | 实测证据 |
|---|---|---|---|
| 急停 | S0双NC切K1线圈并清锁存；硬门控PWM | PB1低进入ESTOP，PB0=0 | 示波器：断电至 PWM 关断 12ms，K1 释放 18ms |
| 上电禁能 | 监督器异步CLR，Q默认0；K1物理START自保持；门控下拉 | 上电待机，须CAL/HB/ARM | 上电 20 次无驱动脉冲；无毛刺 >0.4V |
| 机械限位 | 0/130°挡块；两端双NC微动切线圈/锁存 | PB10/11低禁能，软件10–120° | 接触 0.3°/129.7°；触发至 PWM 关断 14ms |
| 过流 | INA240→双比较器±1.2A，异步清Q/K1 | 电枢电流限幅、PI、超过trip禁能 | 硬件 1.21A/−1.19A，锁存 3.8ms；固件限幅 1.2A |
| 温度 | 壳体NTC→60°C低阈值；断线高阈值 | 60°C故障，45°C以下复位条件 | 60.4°C 锁存；47.0°C RESET 被拒；44.6°C 允许复位 |
| 失联 | 无独立主机看门狗；K1保持但PWM关 | 合法HB超250ms禁能并锁故障 | 实测禁能 258ms（阈值 250ms） |
| MCU卡死 | IWDG与上电拉低；硬急停仍独立 | 独立看门狗复位，重启待机 | 喂狗中止 1.02s 后复位，回到待机、需物理START |
| 故障复位 | 硬故障后必须物理START重建Q/K1 | 物理RESET输入+主机RESET且条件满足 | 26 次复位流程：远端RESET单独无法清实体锁存 |
| 关节反馈异常 | AS5600磁状态/I2C；限位/挡块独立 | 非法/丢失/超范围数据禁能 | 拔 I2C 与磁铁移出均锁存 SENSOR；PWM 关断 9ms |

首版软件、通信、构建、烧录、台架与佩戴验收以本页与[验证记录](validation/README.md)的输出为准。后续变更顺序：保护小板复测→卸载电机→单关节负载台架/复标定→断电人体适配→低力矩佩戴复验。
