le3334515-tech/open-elbow-exoskeleton/hardware/protection_netlist.csv

net | terminal
3V3 | MCU.3V3
3V3 | U1.6
3V3 | U1.7
3V3 | U4.2
3V3 | U4.7
3V3 | U4.8
3V3 | U5.8
3V3 | U7.14
3V3 | U8.VDD
3V3 | R_CLR.1
3V3 | R_NTC.1
3V3 | R_HI_TOP.1
3V3 | R_LO_TOP.1
3V3 | R_TEMP_TOP.1
3V3 | R_OPEN_TOP.1
3V3 | R_I2C_SCL.1
3V3 | R_I2C_SDA.1
3V3 | S0.B_COM
3V3 | S1.B_COM
3V3 | S2.B_COM
3V3 | S3.B_COM
3V3 | S4.COM
3V3 | U6.9
3V3 | U6.12
5V | DC1.OUT+
5V | MCU.5V
5V | M1.ENC_BLUE
5V | U3.8
5V | U6.14
5V | R_BRAKE_PULLUP.1
5V | R_TL431_BIAS.1
GND | PS1.-
GND | DC1.OUT-
GND | MCU.GND
GND | U1.2
GND | U1.3
GND | U1.4
GND | U2.12
GND | U3.4
GND | U4.4
GND | U5.4
GND | U6.7
GND | U6.1
GND | U6.4
GND | U7.7
GND | U8.GND
GND | Q1.E
GND | Q2.S
GND | NTC1.2
GND | M1.ENC_GREEN
GND | R_HI_BOTTOM.2
GND | R_LO_BOTTOM.2
GND | R_TEMP_BOTTOM.2
GND | R_OPEN_BOTTOM.2
GND | R_CLR_DOWN.2
GND | R_S0_DOWN.2
GND | R_S1_DOWN.2
GND | R_S2_DOWN.2
GND | R_START_DOWN.2
GND | R_RESET_DOWN.2
GND | R_A_BOTTOM.2
GND | R_B_BOTTOM.2
GND | R_BUS_BOTTOM.2
GND | R_BRAKE_BOTTOM.2
GND | C_BULK.-
GND | C_ADC_I.2
GND | C_BUS.2
GND | C_DEBOUNCE.2
GND | R_ARM_DOWN.2
GND | R_PWM_DOWN.2
GND | R_GATE_DOWN.2
GND | R_DIR_DOWN.2
GND | R_DRIVER_PWM_DOWN.2
GND | U6.10
GND | U6.13
GND | VR1.TL431A_A
GND | U3.5
GND | U3.6
GND | U7.5
GND | U7.9
GND | U7.11
GND | U7.13
GND | R_Q1_DOWN.2
GND | R_BRAKE_DOWN.2
MOTOR_PLUS_SW | D1.M+
MOTOR_PLUS_SW | RSH1.1
MOTOR_PLUS_SW | U1.8
MOTOR_PLUS | RSH1.2
MOTOR_PLUS | U1.1
MOTOR_PLUS | M1.RED
MOTOR_MINUS | D1.M-
MOTOR_MINUS | M1.BLACK
CURRENT_RAW | U1.5
CURRENT_RAW | U2.4
CURRENT_RAW | U2.7
CURRENT_RAW | R_ADC_I.1
CURRENT_ADC | R_ADC_I.2
CURRENT_ADC | MCU.PA1
CURRENT_ADC | C_ADC_I.1
I_HIGH_REF | R_HI_TOP.2
I_HIGH_REF | R_HI_BOTTOM.1
I_HIGH_REF | U2.5
I_LOW_REF | R_LO_TOP.2
I_LOW_REF | R_LO_BOTTOM.1
I_LOW_REF | U2.6
TEMP_ADC | R_NTC.2
TEMP_ADC | NTC1.1
TEMP_ADC | MCU.PA2
TEMP_ADC | U2.9
TEMP_ADC | U2.10
TEMP_HOT_REF | R_TEMP_TOP.2
TEMP_HOT_REF | R_TEMP_BOTTOM.1
TEMP_HOT_REF | U2.8
TEMP_OPEN_REF | R_OPEN_TOP.2
TEMP_OPEN_REF | R_OPEN_BOTTOM.1
TEMP_OPEN_REF | U2.11
CLR_N | R_CLR.2
CLR_N | R_CLR_DOWN.1
CLR_N | U2.1
CLR_N | U2.2
CLR_N | U2.13
CLR_N | U2.14
CLR_N | U8.RESET_N
CLR_N | U4.6
CLR_N | D_S0.A
CLR_N | D_S1.A
CLR_N | D_S2.A
ESTOP_OK | S0.B_NC
ESTOP_OK | R_S0_DOWN.1
ESTOP_OK | MCU.PB1
ESTOP_OK | D_S0.K
LIMIT_MIN_OK | S1.B_NC
LIMIT_MIN_OK | R_S1_DOWN.1
LIMIT_MIN_OK | MCU.PB10
LIMIT_MIN_OK | D_S1.K
LIMIT_MAX_OK | S2.B_NC
LIMIT_MAX_OK | R_S2_DOWN.1
LIMIT_MAX_OK | MCU.PB11
LIMIT_MAX_OK | D_S2.K
START_RAW | S3.B_NO
START_RAW | R_START_DOWN.1
START_RAW | R_DEBOUNCE.1
START_RC | R_DEBOUNCE.2
START_RC | C_DEBOUNCE.1
START_RC | U7.1
START_INV | U7.2
START_INV | U7.3
START_CLK | U7.4
START_CLK | U4.1
PROTECT_Q | U4.5
PROTECT_Q | U5.6
PROTECT_Q | R_Q1_BASE.1
PROTECT_NOT_Q_UNUSED | U4.3
ARM_GATE | MCU.PB0
ARM_GATE | U5.2
ARM_GATE | R_ARM_DOWN.1
PWM_3V3 | MCU.PA6
PWM_3V3 | U5.1
PWM_3V3 | R_PWM_DOWN.1
PWM_ARM | U5.7
PWM_ARM | U5.5
PWM_GATED | U5.3
PWM_GATED | U6.2
PWM_GATED | R_GATE_DOWN.1
PWM_5V | U6.3
PWM_5V | D1.PWM
PWM_5V | R_DRIVER_PWM_DOWN.1
DIR_3V3 | MCU.PA7
DIR_3V3 | U6.5
DIR_3V3 | R_DIR_DOWN.1
DIR_5V | U6.6
DIR_5V | D1.DIR
MANUAL_RESET | S4.NO
MANUAL_RESET | MCU.PB2
MANUAL_RESET | R_RESET_DOWN.1
BUS_SW | K1.MAIN_NO
BUS_SW | D1.B+
BUS_SW | C_BULK.+
BUS_SW | R_BUS_TOP.1
BUS_SW | R_BRAKE_TOP.1
BUS_SW | R_BRAKE_POWER.1
BUS_ADC | R_BUS_TOP.2
BUS_ADC | R_BUS_BOTTOM.1
BUS_ADC | MCU.PA3
BUS_ADC | C_BUS.1
BRAKE_SENSE | R_BRAKE_TOP.2
BRAKE_SENSE | R_BRAKE_BOTTOM.1
BRAKE_SENSE | U3.3
BRAKE_REF | VR1.TL431A_K
BRAKE_REF | VR1.TL431A_REF
BRAKE_REF | U3.2
BRAKE_REF | R_TL431_BIAS.2
BRAKE_DRIVE | U3.1
BRAKE_DRIVE | R_BRAKE_PULLUP.2
BRAKE_DRIVE | R_BRAKE_GATE.1
BRAKE_GATE | R_BRAKE_GATE.2
BRAKE_GATE | Q2.G
BRAKE_GATE | R_BRAKE_DOWN.1
BRAKE_DRAIN | R_BRAKE_POWER.2
BRAKE_DRAIN | Q2.D
ENC_A_5V | M1.ENC_YELLOW
ENC_A_5V | R_A_TOP.1
ENC_A_3V3 | R_A_TOP.2
ENC_A_3V3 | R_A_BOTTOM.1
ENC_A_3V3 | MCU.PA0
ENC_B_5V | M1.ENC_WHITE
ENC_B_5V | R_B_TOP.1
ENC_B_3V3 | R_B_TOP.2
ENC_B_3V3 | R_B_BOTTOM.1
ENC_B_3V3 | MCU.PB3
I2C_SCL | MCU.PB6
I2C_SCL | ENC1.SCL
I2C_SCL | R_I2C_SCL.2
I2C_SDA | MCU.PB7
I2C_SDA | ENC1.SDA
I2C_SDA | R_I2C_SDA.2
Q1_BASE | R_Q1_BASE.2
Q1_BASE | Q1.B
Q1_BASE | R_Q1_DOWN.1
24V_FUSED | F1.OUT
24V_FUSED | K1.MAIN_COM
24V_FUSED | S0.A_COM
24V_LOGIC | F2.OUT
24V_LOGIC | DC1.VIN+
24V_LOGIC | U2.3
COIL_CHAIN_1 | S0.A_NC
COIL_CHAIN_1 | S1.A_COM
COIL_CHAIN_2 | S1.A_NC
COIL_CHAIN_2 | S2.A_COM
COIL_CHAIN | S2.A_NC
COIL_CHAIN | S3.A_COM
COIL_CHAIN | K1.AUX_COM
COIL_PLUS | S3.A_NO
COIL_PLUS | K1.AUX_NO
COIL_PLUS | K1.A1
COIL_PLUS | D_COIL.K
COIL_LOW | K1.A2
COIL_LOW | Q1.C
COIL_LOW | D_COIL.A
