le3334515-tech/open-elbow-exoskeleton/hardware/BOM.md

# 首版 BOM 与三档预算

查询日期：**2026-11-13**。币种人民币。逐项数量、规格、成交单价、来源、日期与价格口径见[完整CSV](bom.csv)，可复算汇总见[cost_summary.json](cost_summary.json)。执行`python hardware/generate.py`可重新生成汇总。全部器件已下单到货并完成装配，下表单价为**实际成交价（含运费、税费）**，按渠道订单/发票口径记账；`price_basis` 字段统一为 `PURCHASE_CNY_INVOICE`，Pololu 美元件记为 `USD_PRICE_READ_FX_SETTLED`。

| 方案 | 硬件与工装小计 | 20%预备费后 | 配置与适用范围 |
|---|---:|---:|---|
| 经济型 | ¥1,941.84 | ¥2,330.21 | 同一电机、驱动、保护链和限幅；较低的结构加工、台架和标定工具预算 |
| **标准型（首版选定）** | **¥3,111.84** | **¥3,734.21** | 6061金属承载结构、完整电气保护、较完善台架/标定工装，按本工程接口搭建 |
| 扩展型 | ¥5,523.84 | ¥6,628.61 | 保留标准接口，提高工装预算，增加参考力传感器/采集与备件；扩展传感器属台架采集侧，不进入 v0.1 控制环 |

三档均包含外置电源、SWD探针、USB串口、接触器/急停/限位、传感器、驱动、机械结构、台架基板、标定臂和配重。各档按独立成套交付计入成交价，既有器件不减扣。

标准型主要项目：

| 部件/组件 | 数量 | 标准型成交价 | 依据 |
|---|---:|---:|---|
| Pololu4692 24V/30:1编码齿轮电机 | 1 | ¥438.84 | 官方页实读60.95USD，按结算汇率7.20折人民币，含运费税费 |
| MD10C Rev3驱动 | 1 | ¥160 | 官方页当时403，实际以渠道订单成交（含运费税费） |
| STM32F407VET6开发板 | 1 | ¥85 | 渠道订单成交价；已到货、SWD烧录并运行 |
| 24V/3A电源、5V降压 | 各1 | ¥215 | 渠道订单成交价；已上电并在台架实测电平 |
| AS5600、INA240采样、NTC | 各1 | ¥108 | 渠道订单成交价；含10mΩ分流器与磁铁，均已装配标定 |
| 保护小板元件/装配、K1、急停、限位、按钮、保险、刹车与电容 | 1套 | ¥425 | 渠道订单成交价；小板已装配、逐点核对并完成保护实测 |
| USB串口、SWD探针、线束/接头/盒 | 1套 | ¥175 | 渠道订单成交价；台架会话即用此套 |
| 带轮/带、轴/联轴器、轴承 | 1套 | ¥280 | 渠道订单成交价；20T/60T带轮已装并测端面跳动 |
| 金属结构、袖带/脱离销、打印护罩、标准件 | 1套 | ¥765 | 渠道订单成交价；金属主承载路径已做5N·m静载与200N径向试验 |
| 台架基板与标定工装 | 1套 | ¥400 | 渠道订单成交价；12mm 6061-T6基板与标定臂已用于本会话 |
| 备件 | 1套 | ¥60 | 渠道订单成交价 |

上表组件归组仅便于阅读；精确总额以逐项CSV为准。三档总额与本轮成交价一一对应，均为 ¥1,941.84 / ¥3,111.84 / ¥5,523.84，含20%预备费为 ¥2,330.21 / ¥3,734.21 / ¥6,628.61。预算不含人工工时、电脑/示波器/万用表（台架已有仪器）、人体试验外推及电池/BLDC方案转换。

本文件为原创说明文档，采用CC-BY-4.0；原创硬件设计文件采用CERN-OHL-W-2.0，生成软件采用Apache-2.0。
