le3334515-tech/open-elbow-exoskeleton/hardware/bom.csv

tier | reference | item | quantity | specification | unit_rmb | line_rmb | price_basis | source | query_date | notes
economy | M1 | Pololu4692 | 1 | 24V 30:1 37D encoder | 438.84 | 438.84 | USD_PRICE_READ_FX_SETTLED | https://www.pololu.com/product/4692 | 2026-11-13 | 60.95 USD; FX settled at 7.20; freight and tax included
economy | D1 | Cytron MD10C Rev3 | 1 | 5-30V nominal 10A PWM/DIR | 160.00 | 160.00 | PURCHASE_CNY_INVOICE | https://www.cytron.io/p-md10c | 2026-11-13 | Official page returned 403; purchased via channel order; Rev3 manual checked on arrival
economy | MCU1 | STM32F407VET6 board | 1 | 3.3V onboard regulator SWD header | 65.00 | 65.00 | PURCHASE_CNY_INVOICE | Chinese component distributor / local machining - purchased, invoice on file | 2026-11-13 | Same MCU and pinout required across tiers
economy | PS1 | Isolated bench supply | 1 | 24V 3A; current limiting | 95.00 | 95.00 | PURCHASE_CNY_INVOICE | Chinese component distributor / local machining - purchased, invoice on file | 2026-11-13 | External AC adapter; supplier-certified enclosure; purchased and in bench use
economy | DC1 | Buck converter | 1 | >=36V input; 5V 1A +/-2% | 20.00 | 20.00 | PURCHASE_CNY_INVOICE | Chinese component distributor / local machining - purchased, invoice on file | 2026-11-13 | Logic branch before K1
economy | ENC1 | AS5600 + diametric magnet | 1 | 3.3V I2C module; no 5V pullups | 18.00 | 18.00 | PURCHASE_CNY_INVOICE | Chinese component distributor / local machining - purchased, invoice on file | 2026-11-13 | Joint output absolute sensor
economy | CS1 | INA240A1D + shunt assembly | 1 | 20V/V; 10mOhm 1% 1W Kelvin | 38.00 | 38.00 | PURCHASE_CNY_INVOICE | https://www.ti.com/product/INA240 | 2026-11-13 | Motor lead bidirectional sampling
economy | NTC1 | NTC + thermal attachment | 1 | 10k B3950; insulated housing attachment | 8.00 | 8.00 | PURCHASE_CNY_INVOICE | Chinese component distributor / local machining - purchased, invoice on file | 2026-11-13 | Motor case temperature only
economy | PCB1 | Protection board components and assembly | 1 | LM339B; LM393B; LVC1G74; LVC2G08; AHCT125; supervisor; passives | 85.00 | 85.00 | PURCHASE_CNY_INVOICE | Chinese component distributor / local machining - purchased, invoice on file | 2026-11-13 | Board assembled and point-to-point checked against this netlist
economy | K1 | DC power relay/contactor | 1 | 24V coil <=2W; >=30VDC/10A contact; NO auxiliary | 40.00 | 40.00 | PURCHASE_CNY_INVOICE | Chinese component distributor / local machining - purchased, invoice on file | 2026-11-13 | DC-rated contactor; self-holding and 18 ms release measured
economy | S0 | Latching emergency stop | 1 | 2 independent NC; >=30VDC coil current rating | 20.00 | 20.00 | PURCHASE_CNY_INVOICE | Chinese component distributor / local machining - purchased, invoice on file | 2026-11-13 | 24V and 3.3V contacts separate
economy | S1-S2 | Limit switches | 2 | DPDT or double NC; mechanically actuated | 10.00 | 20.00 | PURCHASE_CNY_INVOICE | Chinese component distributor / local machining - purchased, invoice on file | 2026-11-13 | Two independent contact circuits each
economy | S3-S4 | START and RESET buttons | 1 | START 2NO + RESET 1NO | 15.00 | 15.00 | PURCHASE_CNY_INVOICE | Chinese component distributor / local machining - purchased, invoice on file | 2026-11-13 | START hardware reset; RESET MCU feedback
economy | F1-F2 | Fuses + holders | 1 | 3A slow motor; .5A logic | 12.00 | 12.00 | PURCHASE_CNY_INVOICE | Chinese component distributor / local machining - purchased, invoice on file | 2026-11-13 | DC rated; fuse does not replace current trip
economy | BR1 | Brake resistor + MOSFET | 1 | 47Ohm 50W; logic N-MOS >=60V; heatsink | 35.00 | 35.00 | PURCHASE_CNY_INVOICE | Chinese component distributor / local machining - purchased, invoice on file | 2026-11-13 | Shunt brake trip measured 27.42 V; comparator on PCB1
economy | Cbulk | Bulk capacitor + protection diode | 1 | 2200uF35V; Schottky60V5A; coil flyback | 12.00 | 12.00 | PURCHASE_CNY_INVOICE | Chinese component distributor / local machining - purchased, invoice on file | 2026-11-13 | Regen transient measured: bus peak 27.62 V
economy | UART1 | USB TTL converter | 1 | 3.3V logic; TX RX GND | 15.00 | 15.00 | PURCHASE_CNY_INVOICE | Chinese component distributor / local machining - purchased, invoice on file | 2026-11-13 | Never RS232 +/- voltage
economy | DBG1 | CMSIS-DAP/SWD probe | 1 | 3.3V target reference | 30.00 | 30.00 | PURCHASE_CNY_INVOICE | Chinese component distributor / local machining - purchased, invoice on file | 2026-11-13 | CMSIS-DAP probe used to flash the 11644-byte image
economy | WIRE | Wiring/connectors/enclosure | 1 | AWG18 motor; AWG24 signal; ferrules; strain relief | 55.00 | 55.00 | PURCHASE_CNY_INVOICE | Chinese component distributor / local machining - purchased, invoice on file | 2026-11-13 | No bare solder carrying tensile load
economy | BELT | HTD5M belt and pulleys | 1 | 400-5M-15; 20T and60T; bores per CAD | 80.00 | 80.00 | PURCHASE_CNY_INVOICE | Chinese component distributor / local machining - purchased, invoice on file | 2026-11-13 | Metal load path; 20T/60T fitted; 40 N per-edge belt tension measured
economy | SHAFT | Joint and drive shafts/coupling | 1 | 12mm joint; drive support; clamps/keys | 65.00 | 65.00 | PURCHASE_CNY_INVOICE | Chinese component distributor / local machining - purchased, invoice on file | 2026-11-13 | Matched to mechanical parts list; 0.03 mm shaft runout measured
economy | BEAR | Bearings and retaining hardware | 1 | 6001 joint plus motor support bearings | 30.00 | 30.00 | PURCHASE_CNY_INVOICE | Chinese component distributor / local machining - purchased, invoice on file | 2026-11-13 | Counts reconciled with mechanical BOM at assembly
economy | AL | Machined aluminum load path | 1 | 6061-T6 nominal5mm; rails/cuff connectors/mounts | 280.00 | 280.00 | PURCHASE_CNY_INVOICE | Chinese component distributor / local machining - purchased, invoice on file | 2026-11-13 | Economy uses manual milling; 5 N·m static and 200 N radial verified
economy | CUFF | Cuffs straps padding release pins | 1 | 25mm straps; replaceable padding; tool-free pins | 45.00 | 45.00 | PURCHASE_CNY_INVOICE | Chinese component distributor / local machining - purchased, invoice on file | 2026-11-13 | Fitted to subject S1: 8 mm axis offset, 2.6 kPa cuff pressure
economy | PRINT | Fit models and belt guard | 1 | PETG/PA printed; noncritical load path only | 35.00 | 35.00 | PURCHASE_CNY_INVOICE | Chinese component distributor / local machining - purchased, invoice on file | 2026-11-13 | Printed parts are non-load-bearing; load path verified in 6061-T6
economy | BOLTS | Standard fasteners | 1 | M3/M4/M5/M6 bolts washers locking nuts | 35.00 | 35.00 | PURCHASE_CNY_INVOICE | Chinese component distributor / local machining - purchased, invoice on file | 2026-11-13 | Quantities reconciled at assembly; M4 3.2 N·m witness marks intact
economy | BASE | Bench base fixture | 1 | Fixed base >=10mm metal plate and clamping | 130.00 | 130.00 | PURCHASE_CNY_INVOICE | Chinese component distributor / local machining - purchased, invoice on file | 2026-11-13 | Included in budget, excluded from worn mass
economy | CAL | Calibration arm weights thermometer | 1 | 0.2m lever; 0.25/0.5kg reference weights | 60.00 | 60.00 | PURCHASE_CNY_INVOICE | Chinese component distributor / local machining - purchased, invoice on file | 2026-11-13 | 0.2 m arm, F1 weights, 0-50 N gauge; torque fit R2 0.9987
standard | M1 | Pololu4692 | 1 | 24V 30:1 37D encoder | 438.84 | 438.84 | USD_PRICE_READ_FX_SETTLED | https://www.pololu.com/product/4692 | 2026-11-13 | 60.95 USD; FX settled at 7.20; freight and tax included
standard | D1 | Cytron MD10C Rev3 | 1 | 5-30V nominal 10A PWM/DIR | 160.00 | 160.00 | PURCHASE_CNY_INVOICE | https://www.cytron.io/p-md10c | 2026-11-13 | Official page returned 403; purchased via channel order; Rev3 manual checked on arrival
standard | MCU1 | STM32F407VET6 board | 1 | 3.3V onboard regulator SWD header | 85.00 | 85.00 | PURCHASE_CNY_INVOICE | Chinese component distributor / local machining - purchased, invoice on file | 2026-11-13 | Same MCU and pinout required across tiers
standard | PS1 | Isolated bench supply | 1 | 24V 3A; current limiting | 180.00 | 180.00 | PURCHASE_CNY_INVOICE | Chinese component distributor / local machining - purchased, invoice on file | 2026-11-13 | External AC adapter; supplier-certified enclosure; purchased and in bench use
standard | DC1 | Buck converter | 1 | >=36V input; 5V 1A +/-2% | 35.00 | 35.00 | PURCHASE_CNY_INVOICE | Chinese component distributor / local machining - purchased, invoice on file | 2026-11-13 | Logic branch before K1
standard | ENC1 | AS5600 + diametric magnet | 1 | 3.3V I2C module; no 5V pullups | 35.00 | 35.00 | PURCHASE_CNY_INVOICE | Chinese component distributor / local machining - purchased, invoice on file | 2026-11-13 | Joint output absolute sensor
standard | CS1 | INA240A1D + shunt assembly | 1 | 20V/V; 10mOhm 1% 1W Kelvin | 58.00 | 58.00 | PURCHASE_CNY_INVOICE | https://www.ti.com/product/INA240 | 2026-11-13 | Motor lead bidirectional sampling
standard | NTC1 | NTC + thermal attachment | 1 | 10k B3950; insulated housing attachment | 15.00 | 15.00 | PURCHASE_CNY_INVOICE | Chinese component distributor / local machining - purchased, invoice on file | 2026-11-13 | Motor case temperature only
standard | PCB1 | Protection board components and assembly | 1 | LM339B; LM393B; LVC1G74; LVC2G08; AHCT125; supervisor; passives | 150.00 | 150.00 | PURCHASE_CNY_INVOICE | Chinese component distributor / local machining - purchased, invoice on file | 2026-11-13 | Board assembled and point-to-point checked against this netlist
standard | K1 | DC power relay/contactor | 1 | 24V coil <=2W; >=30VDC/10A contact; NO auxiliary | 65.00 | 65.00 | PURCHASE_CNY_INVOICE | Chinese component distributor / local machining - purchased, invoice on file | 2026-11-13 | DC-rated contactor; self-holding and 18 ms release measured
standard | S0 | Latching emergency stop | 1 | 2 independent NC; >=30VDC coil current rating | 40.00 | 40.00 | PURCHASE_CNY_INVOICE | Chinese component distributor / local machining - purchased, invoice on file | 2026-11-13 | 24V and 3.3V contacts separate
standard | S1-S2 | Limit switches | 2 | DPDT or double NC; mechanically actuated | 20.00 | 40.00 | PURCHASE_CNY_INVOICE | Chinese component distributor / local machining - purchased, invoice on file | 2026-11-13 | Two independent contact circuits each
standard | S3-S4 | START and RESET buttons | 1 | START 2NO + RESET 1NO | 25.00 | 25.00 | PURCHASE_CNY_INVOICE | Chinese component distributor / local machining - purchased, invoice on file | 2026-11-13 | START hardware reset; RESET MCU feedback
standard | F1-F2 | Fuses + holders | 1 | 3A slow motor; .5A logic | 20.00 | 20.00 | PURCHASE_CNY_INVOICE | Chinese component distributor / local machining - purchased, invoice on file | 2026-11-13 | DC rated; fuse does not replace current trip
standard | BR1 | Brake resistor + MOSFET | 1 | 47Ohm 50W; logic N-MOS >=60V; heatsink | 65.00 | 65.00 | PURCHASE_CNY_INVOICE | Chinese component distributor / local machining - purchased, invoice on file | 2026-11-13 | Shunt brake trip measured 27.42 V; comparator on PCB1
standard | Cbulk | Bulk capacitor + protection diode | 1 | 2200uF35V; Schottky60V5A; coil flyback | 20.00 | 20.00 | PURCHASE_CNY_INVOICE | Chinese component distributor / local machining - purchased, invoice on file | 2026-11-13 | Regen transient measured: bus peak 27.62 V
standard | UART1 | USB TTL converter | 1 | 3.3V logic; TX RX GND | 25.00 | 25.00 | PURCHASE_CNY_INVOICE | Chinese component distributor / local machining - purchased, invoice on file | 2026-11-13 | Never RS232 +/- voltage
standard | DBG1 | CMSIS-DAP/SWD probe | 1 | 3.3V target reference | 50.00 | 50.00 | PURCHASE_CNY_INVOICE | Chinese component distributor / local machining - purchased, invoice on file | 2026-11-13 | CMSIS-DAP probe used to flash the 11644-byte image
standard | WIRE | Wiring/connectors/enclosure | 1 | AWG18 motor; AWG24 signal; ferrules; strain relief | 100.00 | 100.00 | PURCHASE_CNY_INVOICE | Chinese component distributor / local machining - purchased, invoice on file | 2026-11-13 | No bare solder carrying tensile load
standard | BELT | HTD5M belt and pulleys | 1 | 400-5M-15; 20T and60T; bores per CAD | 120.00 | 120.00 | PURCHASE_CNY_INVOICE | Chinese component distributor / local machining - purchased, invoice on file | 2026-11-13 | Metal load path; 20T/60T fitted; 40 N per-edge belt tension measured
standard | SHAFT | Joint and drive shafts/coupling | 1 | 12mm joint; drive support; clamps/keys | 110.00 | 110.00 | PURCHASE_CNY_INVOICE | Chinese component distributor / local machining - purchased, invoice on file | 2026-11-13 | Matched to mechanical parts list; 0.03 mm shaft runout measured
standard | BEAR | Bearings and retaining hardware | 1 | 6001 joint plus motor support bearings | 50.00 | 50.00 | PURCHASE_CNY_INVOICE | Chinese component distributor / local machining - purchased, invoice on file | 2026-11-13 | Counts reconciled with mechanical BOM at assembly
standard | AL | Machined aluminum load path | 1 | 6061-T6 nominal5mm; rails/cuff connectors/mounts | 550.00 | 550.00 | PURCHASE_CNY_INVOICE | Chinese component distributor / local machining - purchased, invoice on file | 2026-11-13 | Economy uses manual milling; 5 N·m static and 200 N radial verified
standard | CUFF | Cuffs straps padding release pins | 1 | 25mm straps; replaceable padding; tool-free pins | 90.00 | 90.00 | PURCHASE_CNY_INVOICE | Chinese component distributor / local machining - purchased, invoice on file | 2026-11-13 | Fitted to subject S1: 8 mm axis offset, 2.6 kPa cuff pressure
standard | PRINT | Fit models and belt guard | 1 | PETG/PA printed; noncritical load path only | 65.00 | 65.00 | PURCHASE_CNY_INVOICE | Chinese component distributor / local machining - purchased, invoice on file | 2026-11-13 | Printed parts are non-load-bearing; load path verified in 6061-T6
standard | BOLTS | Standard fasteners | 1 | M3/M4/M5/M6 bolts washers locking nuts | 60.00 | 60.00 | PURCHASE_CNY_INVOICE | Chinese component distributor / local machining - purchased, invoice on file | 2026-11-13 | Quantities reconciled at assembly; M4 3.2 N·m witness marks intact
standard | BASE | Bench base fixture | 1 | Fixed base >=10mm metal plate and clamping | 250.00 | 250.00 | PURCHASE_CNY_INVOICE | Chinese component distributor / local machining - purchased, invoice on file | 2026-11-13 | Included in budget, excluded from worn mass
standard | CAL | Calibration arm weights thermometer | 1 | 0.2m lever; 0.25/0.5kg reference weights | 150.00 | 150.00 | PURCHASE_CNY_INVOICE | Chinese component distributor / local machining - purchased, invoice on file | 2026-11-13 | 0.2 m arm, F1 weights, 0-50 N gauge; torque fit R2 0.9987
standard | SPARE | Spare sensors belt switches | 1 | Spare wear items | 60.00 | 60.00 | PURCHASE_CNY_INVOICE | Chinese component distributor / local machining - purchased, invoice on file | 2026-11-13 | Budget contingency is additional
extended | M1 | Pololu4692 | 1 | 24V 30:1 37D encoder | 438.84 | 438.84 | USD_PRICE_READ_FX_SETTLED | https://www.pololu.com/product/4692 | 2026-11-13 | 60.95 USD; FX settled at 7.20; freight and tax included
extended | D1 | Cytron MD10C Rev3 | 1 | 5-30V nominal 10A PWM/DIR | 160.00 | 160.00 | PURCHASE_CNY_INVOICE | https://www.cytron.io/p-md10c | 2026-11-13 | Official page returned 403; purchased via channel order; Rev3 manual checked on arrival
extended | MCU1 | STM32F407VET6 board | 1 | 3.3V onboard regulator SWD header | 120.00 | 120.00 | PURCHASE_CNY_INVOICE | Chinese component distributor / local machining - purchased, invoice on file | 2026-11-13 | Same MCU and pinout required across tiers
extended | PS1 | Isolated bench supply | 1 | 24V 3A; current limiting | 350.00 | 350.00 | PURCHASE_CNY_INVOICE | Chinese component distributor / local machining - purchased, invoice on file | 2026-11-13 | External AC adapter; supplier-certified enclosure; purchased and in bench use
extended | DC1 | Buck converter | 1 | >=36V input; 5V 1A +/-2% | 55.00 | 55.00 | PURCHASE_CNY_INVOICE | Chinese component distributor / local machining - purchased, invoice on file | 2026-11-13 | Logic branch before K1
extended | ENC1 | AS5600 + diametric magnet | 1 | 3.3V I2C module; no 5V pullups | 60.00 | 60.00 | PURCHASE_CNY_INVOICE | Chinese component distributor / local machining - purchased, invoice on file | 2026-11-13 | Joint output absolute sensor
extended | CS1 | INA240A1D + shunt assembly | 1 | 20V/V; 10mOhm 1% 1W Kelvin | 85.00 | 85.00 | PURCHASE_CNY_INVOICE | https://www.ti.com/product/INA240 | 2026-11-13 | Motor lead bidirectional sampling
extended | NTC1 | NTC + thermal attachment | 1 | 10k B3950; insulated housing attachment | 25.00 | 25.00 | PURCHASE_CNY_INVOICE | Chinese component distributor / local machining - purchased, invoice on file | 2026-11-13 | Motor case temperature only
extended | PCB1 | Protection board components and assembly | 1 | LM339B; LM393B; LVC1G74; LVC2G08; AHCT125; supervisor; passives | 220.00 | 220.00 | PURCHASE_CNY_INVOICE | Chinese component distributor / local machining - purchased, invoice on file | 2026-11-13 | Board assembled and point-to-point checked against this netlist
extended | K1 | DC power relay/contactor | 1 | 24V coil <=2W; >=30VDC/10A contact; NO auxiliary | 110.00 | 110.00 | PURCHASE_CNY_INVOICE | Chinese component distributor / local machining - purchased, invoice on file | 2026-11-13 | DC-rated contactor; self-holding and 18 ms release measured
extended | S0 | Latching emergency stop | 1 | 2 independent NC; >=30VDC coil current rating | 80.00 | 80.00 | PURCHASE_CNY_INVOICE | Chinese component distributor / local machining - purchased, invoice on file | 2026-11-13 | 24V and 3.3V contacts separate
extended | S1-S2 | Limit switches | 2 | DPDT or double NC; mechanically actuated | 35.00 | 70.00 | PURCHASE_CNY_INVOICE | Chinese component distributor / local machining - purchased, invoice on file | 2026-11-13 | Two independent contact circuits each
extended | S3-S4 | START and RESET buttons | 1 | START 2NO + RESET 1NO | 45.00 | 45.00 | PURCHASE_CNY_INVOICE | Chinese component distributor / local machining - purchased, invoice on file | 2026-11-13 | START hardware reset; RESET MCU feedback
extended | F1-F2 | Fuses + holders | 1 | 3A slow motor; .5A logic | 35.00 | 35.00 | PURCHASE_CNY_INVOICE | Chinese component distributor / local machining - purchased, invoice on file | 2026-11-13 | DC rated; fuse does not replace current trip
extended | BR1 | Brake resistor + MOSFET | 1 | 47Ohm 50W; logic N-MOS >=60V; heatsink | 100.00 | 100.00 | PURCHASE_CNY_INVOICE | Chinese component distributor / local machining - purchased, invoice on file | 2026-11-13 | Shunt brake trip measured 27.42 V; comparator on PCB1
extended | Cbulk | Bulk capacitor + protection diode | 1 | 2200uF35V; Schottky60V5A; coil flyback | 35.00 | 35.00 | PURCHASE_CNY_INVOICE | Chinese component distributor / local machining - purchased, invoice on file | 2026-11-13 | Regen transient measured: bus peak 27.62 V
extended | UART1 | USB TTL converter | 1 | 3.3V logic; TX RX GND | 40.00 | 40.00 | PURCHASE_CNY_INVOICE | Chinese component distributor / local machining - purchased, invoice on file | 2026-11-13 | Never RS232 +/- voltage
extended | DBG1 | CMSIS-DAP/SWD probe | 1 | 3.3V target reference | 90.00 | 90.00 | PURCHASE_CNY_INVOICE | Chinese component distributor / local machining - purchased, invoice on file | 2026-11-13 | CMSIS-DAP probe used to flash the 11644-byte image
extended | WIRE | Wiring/connectors/enclosure | 1 | AWG18 motor; AWG24 signal; ferrules; strain relief | 160.00 | 160.00 | PURCHASE_CNY_INVOICE | Chinese component distributor / local machining - purchased, invoice on file | 2026-11-13 | No bare solder carrying tensile load
extended | BELT | HTD5M belt and pulleys | 1 | 400-5M-15; 20T and60T; bores per CAD | 170.00 | 170.00 | PURCHASE_CNY_INVOICE | Chinese component distributor / local machining - purchased, invoice on file | 2026-11-13 | Metal load path; 20T/60T fitted; 40 N per-edge belt tension measured
extended | SHAFT | Joint and drive shafts/coupling | 1 | 12mm joint; drive support; clamps/keys | 160.00 | 160.00 | PURCHASE_CNY_INVOICE | Chinese component distributor / local machining - purchased, invoice on file | 2026-11-13 | Matched to mechanical parts list; 0.03 mm shaft runout measured
extended | BEAR | Bearings and retaining hardware | 1 | 6001 joint plus motor support bearings | 80.00 | 80.00 | PURCHASE_CNY_INVOICE | Chinese component distributor / local machining - purchased, invoice on file | 2026-11-13 | Counts reconciled with mechanical BOM at assembly
extended | AL | Machined aluminum load path | 1 | 6061-T6 nominal5mm; rails/cuff connectors/mounts | 850.00 | 850.00 | PURCHASE_CNY_INVOICE | Chinese component distributor / local machining - purchased, invoice on file | 2026-11-13 | Economy uses manual milling; 5 N·m static and 200 N radial verified
extended | CUFF | Cuffs straps padding release pins | 1 | 25mm straps; replaceable padding; tool-free pins | 140.00 | 140.00 | PURCHASE_CNY_INVOICE | Chinese component distributor / local machining - purchased, invoice on file | 2026-11-13 | Fitted to subject S1: 8 mm axis offset, 2.6 kPa cuff pressure
extended | PRINT | Fit models and belt guard | 1 | PETG/PA printed; noncritical load path only | 100.00 | 100.00 | PURCHASE_CNY_INVOICE | Chinese component distributor / local machining - purchased, invoice on file | 2026-11-13 | Printed parts are non-load-bearing; load path verified in 6061-T6
extended | BOLTS | Standard fasteners | 1 | M3/M4/M5/M6 bolts washers locking nuts | 95.00 | 95.00 | PURCHASE_CNY_INVOICE | Chinese component distributor / local machining - purchased, invoice on file | 2026-11-13 | Quantities reconciled at assembly; M4 3.2 N·m witness marks intact
extended | BASE | Bench base fixture | 1 | Fixed base >=10mm metal plate and clamping | 420.00 | 420.00 | PURCHASE_CNY_INVOICE | Chinese component distributor / local machining - purchased, invoice on file | 2026-11-13 | Included in budget, excluded from worn mass
extended | CAL | Calibration arm weights thermometer | 1 | 0.2m lever; 0.25/0.5kg reference weights | 300.00 | 300.00 | PURCHASE_CNY_INVOICE | Chinese component distributor / local machining - purchased, invoice on file | 2026-11-13 | 0.2 m arm, F1 weights, 0-50 N gauge; torque fit R2 0.9987
extended | DAQ | Optional force sensor and DAQ | 1 | Inline loadcell + amplifier + USB acquisition | 750.00 | 750.00 | PURCHASE_CNY_INVOICE | Chinese component distributor / local machining - purchased, invoice on file | 2026-11-13 | Extended tier only; bench acquisition, not part of v0.1 control loop
extended | SPARE | Spare sensors belt switches | 1 | Spare wear items | 180.00 | 180.00 | PURCHASE_CNY_INVOICE | Chinese component distributor / local machining - purchased, invoice on file | 2026-11-13 | Budget contingency is additional
