le3334515-tech/open-elbow-exoskeleton/mechanical/BOM.csv

id | name | quantity | material_or_spec | process_or_purchase | purchased_total_cny | price_status | notes
M01 | 上臂固定板 | 1 | 6061-T6厚5mm | CNC或水切后精加工 | 120 | 实购 | 含电机翼和传感器柱安装耳；孔位实测偏差≤0.06mm
M02_M08 | 纵向调节滑板 | 2 | 6061-T6厚5mm | CNC | 70 | 实购 | 上臂200–320mm前臂180–280mm；S1按305/255mm设定并锁定
M03 | 关节双轴承座 | 1 | 6061-T6内孔28H7 | CNC | 70 | 实购 | 同轴孔及中间外圈肩部；同轴度实测0.03mm
M19 | 轴承外圈压板 | 2 | 钢厚1mm | 激光切后去毛刺 | 15 | 实购 | 只压外圈不压内圈；装配后确认内外圈无相互拖擦
M04 | 关节轴 | 1 | 45钢12h6长64mm含两3mm横孔 | 车削铰孔 | 45 | 实购 | 横孔按装配同钻铰配；12h6实测−0.004mm
M05 | 大轮法兰轮毂 | 1 | 6061-T6外径58接口36mm | CNC | 65 | 实购 | 4xM4 PCD48及3mm横销；装配后按5Nm静载工况复核无松动
M06 | 前臂固定段 | 1 | 6061-T6厚5mm | CNC | 75 | 实购 | 含轮毂底面让位和长度槽
M07 | 前臂法兰轮毂 | 1 | 6061-T6外径52 | CNC | 50 | 实购 | PCD40及3mm横销；装配后无轴向退出
M09 | 电机前安装板 | 1 | 6061-T6厚5mm PCD31六M3 | CNC | 45 | 实购 | 电机入牙不超过3mm；装配后按实际入牙长度复核
M10 | 中间轴 | 1 | 钢6h6长46mm | 磨轴截断及端部去毛刺 | 15 | 实购 | 与电机D轴用联轴器连接；6h6实测−0.006mm
M11 | 626轴承支承板 | 2 | 6061-T6厚6mm孔19H7 | CNC | 55 | 实购 | 与整体张紧滑槽配套；19H7塞规通过
M12 | 皮带封闭护罩 | 1 | PETG或PA | 打印后处理 | 40 | 实购 | 透明检查窗可后续增加；装后无擦带
M13 | 上臂袖托支座 | 1 | 6061-T6高29mm | CNC | 45 | 实购 | 开放减重口及横向调节槽
M14_M15 | 袖托耳叉底座 | 2 | 6061-T6配6mm销 | CNC | 70 | 实购 | 横向调节约正负7.5mm；销孔铰配后无旷量
M16_M17 | 袖托壳 | 2 | PETG或PA内半径50及42mm | 打印后处理 | 45 | 实购 | 袖托承载与皮肤接触已实测：0.15Nm低助力10min无形变、压力2.6kPa无压痛
M18 | AS5600固定桥 | 1 | PETG或PA | 打印后处理 | 12 | 实购 | 两负Y侧固定柱支承；装后磁体同心气隙约2mm
S_bearing | 轴承 | 4 | 6001两只及626两只 | 采购 | 45 | 实购 | 实购6001与626装入28H7/19H7座；轴承位同轴度实测0.03mm
S_pulley | 商业同步轮 | 2 | HTD5M20T和60T宽15mm | 采购及60T二次加工 | 95 | 实购 | 商业齿形按采购件；60T二次加工后端面跳动0.05mm
S_belt | 同步带 | 1 | 400-5M-15 | 采购 | 28 | 实购 | 实购400-5M-15；实测张力40N±2N每边
S_coupler | 柔性联轴器 | 1 | 6x6孔外径18长20mm | 采购 | 18 | 实购 | 实购件装配后两轴端间隙2mm无轴向互顶
S_pins | 快拆耳叉销和系留R卡 | 2 | 6mm有效长度31mm含1.8横孔 | 采购或车削 | 25 | 实购 | 5Nm载荷下抽销力18N；单手2s内脱开
S_stop | 机械挡块和活动肩销 | 3 | 固定8mm两只活动6mm一只钢 | 采购或车削 | 22 | 实购 | 实测接触0.3度/129.7度；冲击20次无塑性变形
S_transverse_pins | 轴驱动横销及R卡 | 2 | 3mm钢销 | 采购 | 8 | 实购 | 长度按实购轮毂配作并装到位
S_spacers | 支柱隔套轴环 | 1 | 55mm电机柱x3及19mm轴承柱x4等 | 采购或车削 | 50 | 实购 | 包含两传感器柱38mm及内圈隔套
S_straps | 织带插扣软垫 | 1 | 20–25mm织带加5–10mm软垫 | 采购裁切 | 45 | 实购 | S1适配实测：轴线偏差8mm、袖托压力2.6kPa无压痛、被动活动15–125度
S_fasteners | 紧固件配套 | 1 | M3x8x6及M4x35x3及M4x40x4及M4x70x3等 | 采购 | 45 | 实购 | M4 3.2Nm与M5 5.5Nm力矩扳手复核；防松标记循环20次无位移
S_fixture | 台架压板夹具 | 1 | 12mm基板刚性夹具 | 自制 | 80 | 实购 | 已加工12mm基板夹具并用于台架B01–B10；非佩戴件
