le3334515-tech/open-elbow-exoskeleton/mechanical/exports/assembly.step

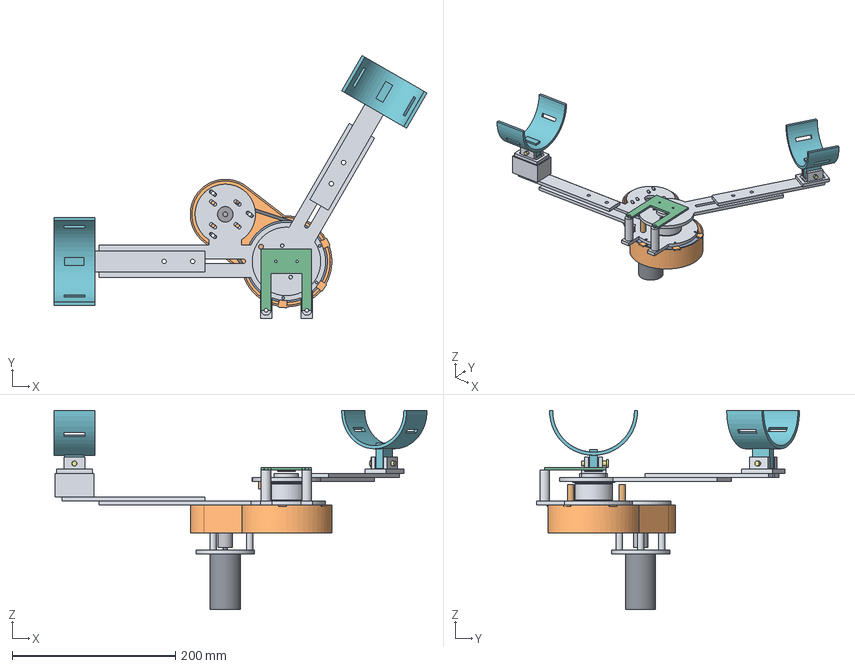
[picture p2: CAD file, 2026-11-13]
mechanical/exports/assembly.step
457.3 x 322.5 x 244.0 mm
M01_upper_fixed_plate
M02_upper_telescopic_slider
M03_joint_bearing_housing
M19_bearing_retainer_0
M19_bearing_retainer_1
S18_lower_shaft_collar_ENVELOPE
S19_upper_shaft_spacer
S01_bearing_6001_lower
S02_bearing_6001_upper
M04_joint_shaft_12mm
M05_pulley_clamp_hub
S03_HTD5M_60T_pulley_ENVELOPE
M06_forearm_rotating_plate
M07_forearm_clamp_hub
M08_forearm_telescopic_slider
S04_rotating_stop_shoulder_pin
S05_0_fixed_stop_stud
S05_1_fixed_stop_stud
M09_motor_front_adapter
S06_motor_standoff_0
S06_motor_standoff_1
S06_motor_standoff_2
S07_Pololu_4692_ENVELOPE
S08_flexible_coupler_6x6_ENVELOPE
M10_motor_jackshaft_6mm
M11_jackshaft_bearing_plate_0
S09_bearing_626_0
M11_jackshaft_bearing_plate_1
S09_bearing_626_1
S10_jackshaft_spacer_0
S10_jackshaft_spacer_1
S10_jackshaft_spacer_2
S10_jackshaft_spacer_3
S11_HTD5M_20T_pulley_ENVELOPE
S12_HTD5M_400_15_belt_ENVELOPE
M12_belt_guard
M13_upper_cuff_riser
M14_upper_cuff_clevis
M15_forearm_cuff_clevis
M16_upper_cuff_shell
M17_forearm_cuff_shell
S13_upper_cuff_quick_pin
S14_forearm_cuff_quick_pin
S16_sensor_bridge_post_-25
S16_sensor_bridge_post_25
M18_AS5600_sensor_bridge
S17_AS5600_PCB_ENVELOPE
S15_diametric_magnet_6x2
