le3334515-tech/open-elbow-exoskeleton/mechanical/exports/parts/S07_Pololu_4692_ENVELOPE.step

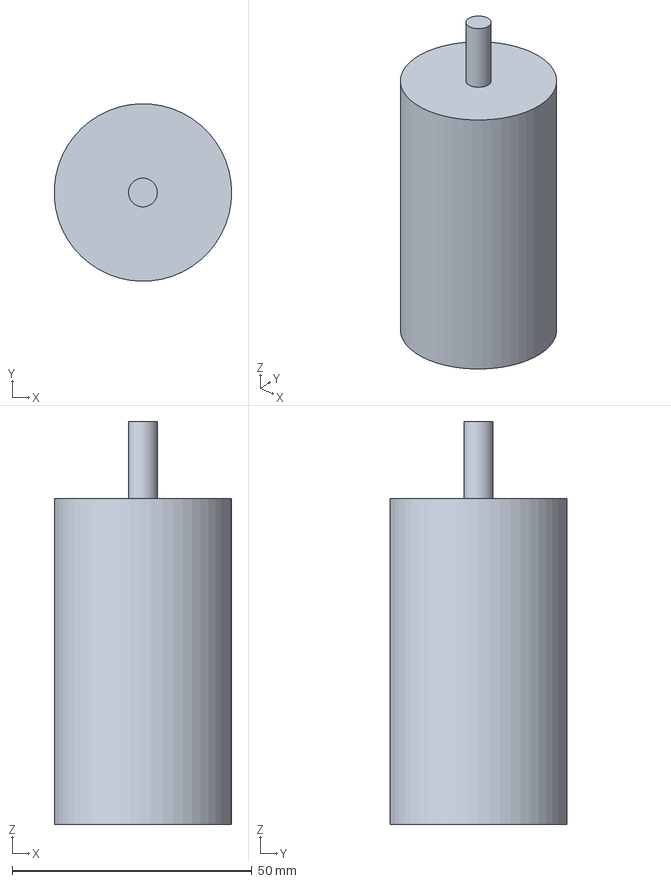
[picture p3: CAD file, 2026-11-13]
mechanical/exports/parts/S07_Pololu_4692_ENVELOPE.step
37.0 x 37.0 x 84.0 mm
