le3334515-tech/open-elbow-exoskeleton/mechanical/exports/parts/M16_upper_cuff_shell.step

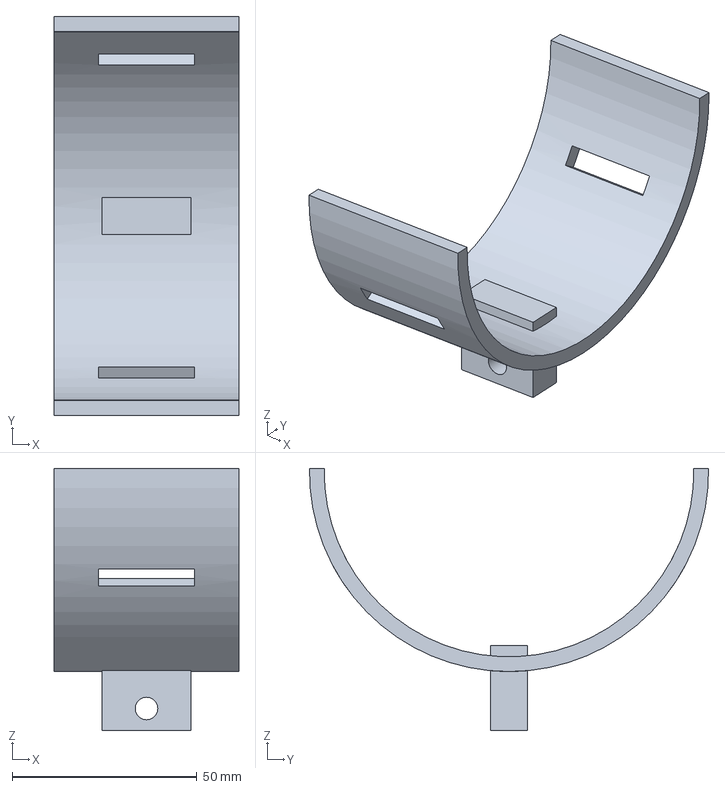
[picture p4: CAD file, 2026-11-13]
mechanical/exports/parts/M16_upper_cuff_shell.step
50.0 x 108.0 x 71.0 mm
