le3334515-tech/open-elbow-exoskeleton/mechanical/exports/parts/M18_AS5600_sensor_bridge.step

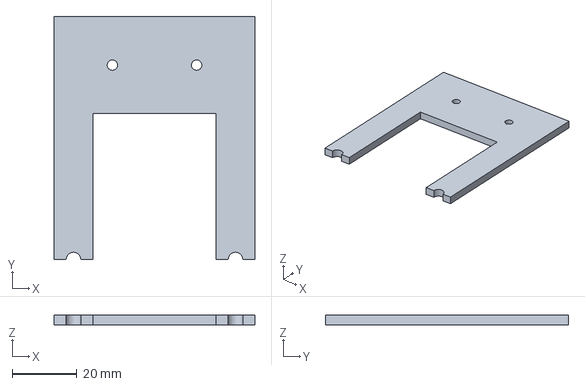
[picture p5: CAD file, 2026-11-13]
mechanical/exports/parts/M18_AS5600_sensor_bridge.step
62.0 x 75.0 x 3.00 mm
