le3334515-tech/open-elbow-exoskeleton/mechanical/exports/parts/M08_forearm_telescopic_slider.step

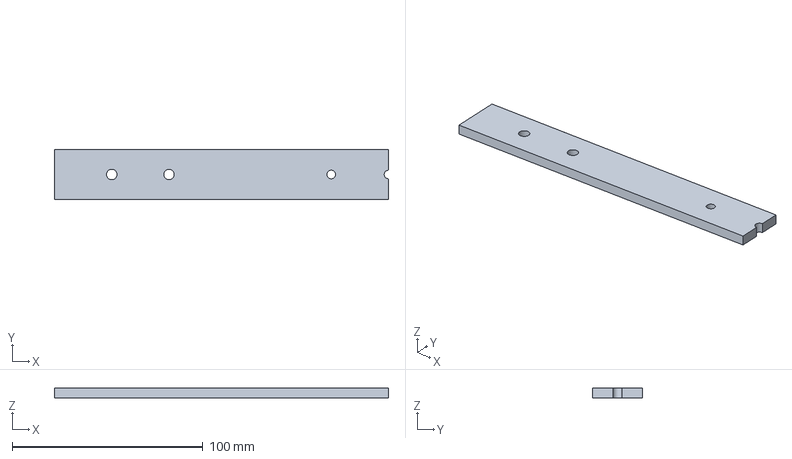
[picture p6: CAD file, 2026-11-13]
mechanical/exports/parts/M08_forearm_telescopic_slider.step
175.0 x 26.0 x 5.00 mm
