le3334515-tech/open-elbow-exoskeleton/mechanical/exports/parts/M15_forearm_cuff_clevis.step

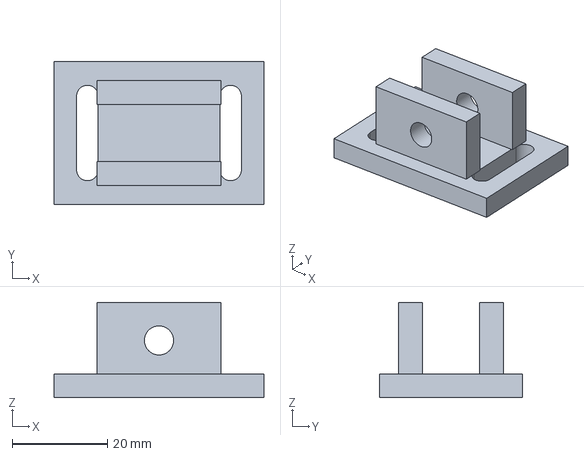
[picture p7: CAD file, 2026-11-13]
mechanical/exports/parts/M15_forearm_cuff_clevis.step
44.0 x 30.0 x 20.0 mm
