le3334515-tech/open-elbow-exoskeleton/mechanical/exports/parts/M11_jackshaft_bearing_plate_0.step

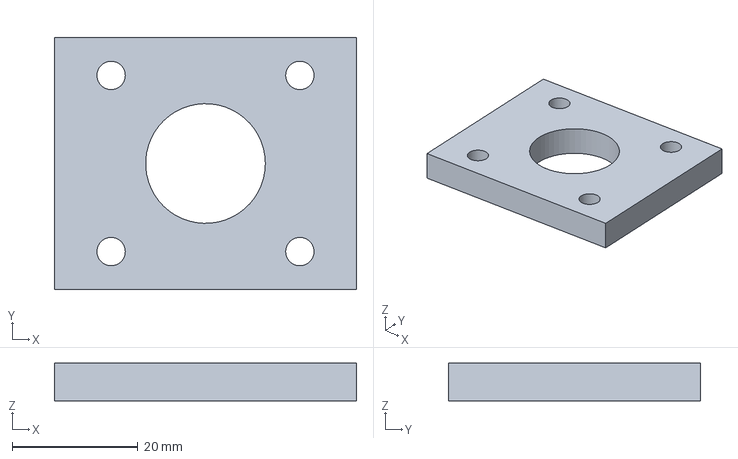
[picture p8: CAD file, 2026-11-13]
mechanical/exports/parts/M11_jackshaft_bearing_plate_0.step
48.0 x 40.0 x 6.00 mm
