le3334515-tech/open-elbow-exoskeleton/mechanical/exports/parts/M07_forearm_clamp_hub.step

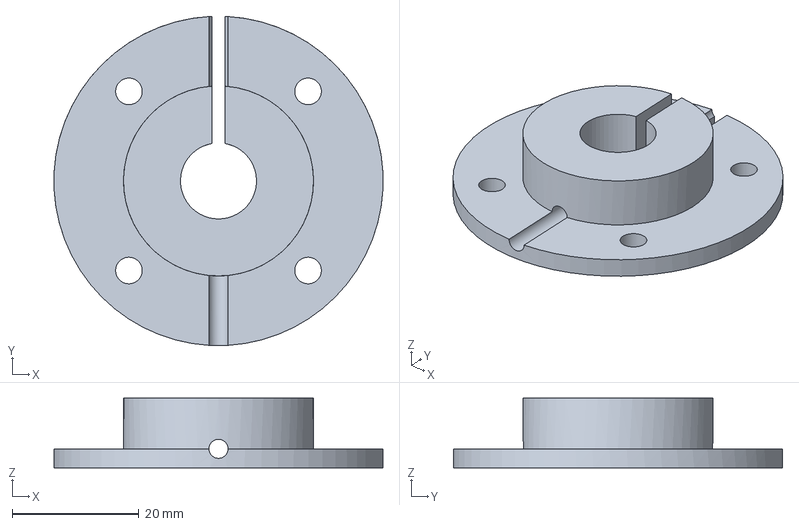
[picture p9: CAD file, 2026-11-13]
mechanical/exports/parts/M07_forearm_clamp_hub.step
51.9 x 52.0 x 11.0 mm
