le3334515-tech/open-elbow-exoskeleton/mechanical/exports/parts/M17_forearm_cuff_shell.step

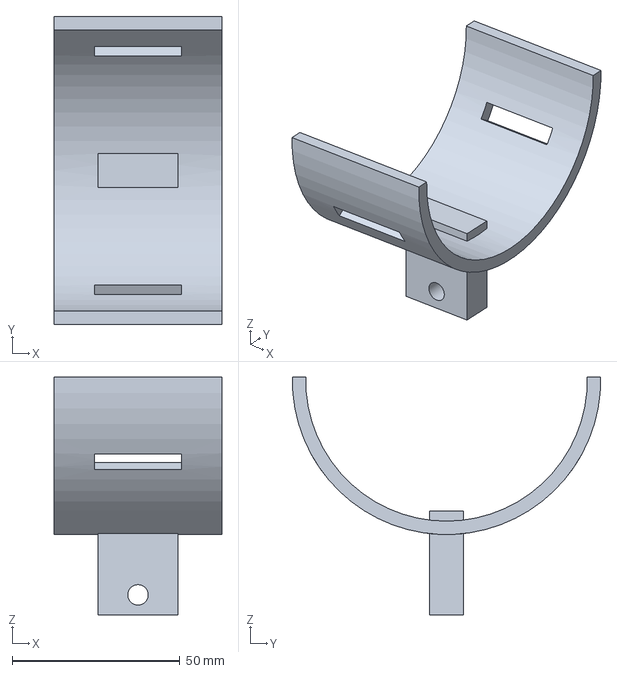
[picture p10: CAD file, 2026-11-13]
mechanical/exports/parts/M17_forearm_cuff_shell.step
50.0 x 92.0 x 71.0 mm
