le3334515-tech/open-elbow-exoskeleton/mechanical/exports/parts/M01_upper_fixed_plate.step

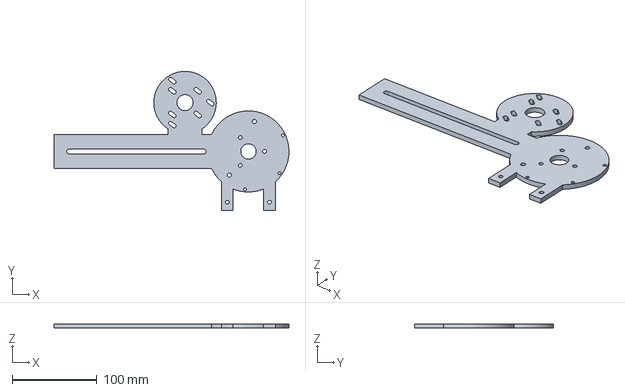
[picture p11: CAD file, 2026-11-13]
mechanical/exports/parts/M01_upper_fixed_plate.step
278.0 x 164.7 x 5.00 mm
