le3334515-tech/open-elbow-exoskeleton/mechanical/exports/parts/S09_bearing_626_0.step

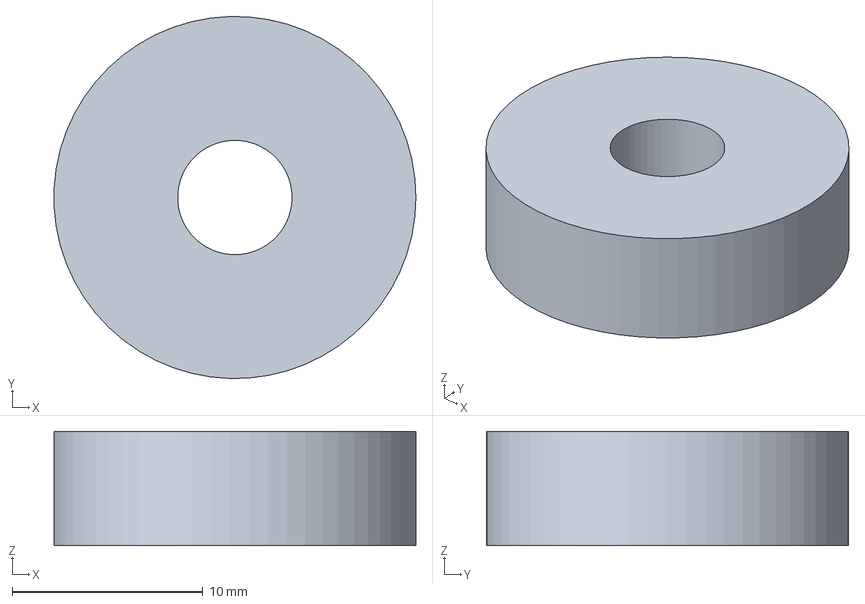
[picture p12: CAD file, 2026-11-13]
mechanical/exports/parts/S09_bearing_626_0.step
19.0 x 19.0 x 6.00 mm
