le3334515-tech/open-elbow-exoskeleton/mechanical/exports/parts/M19_bearing_retainer_1.step

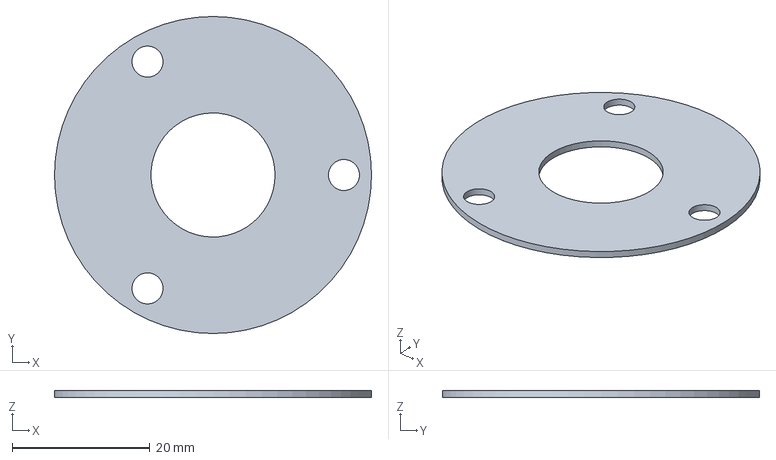
[picture p13: CAD file, 2026-11-13]
mechanical/exports/parts/M19_bearing_retainer_1.step
46.0 x 46.0 x 1.00 mm
