le3334515-tech/open-elbow-exoskeleton/mechanical/exports/parts/S05_0_fixed_stop_stud.step

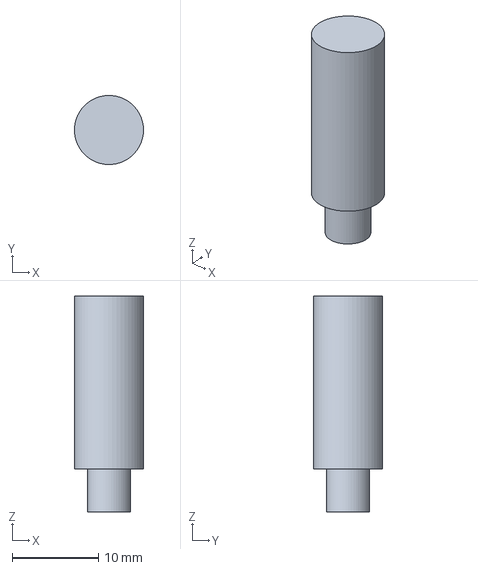
[picture p14: CAD file, 2026-11-13]
mechanical/exports/parts/S05_0_fixed_stop_stud.step
7.99 x 8.00 x 25.0 mm
