le3334515-tech/open-elbow-exoskeleton/mechanical/exports/parts/S03_HTD5M_60T_pulley_ENVELOPE.step

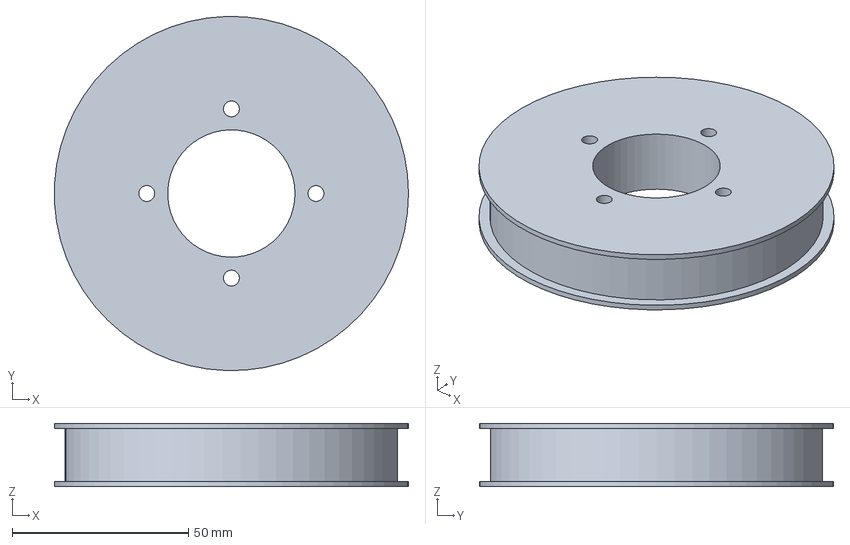
[picture p15: CAD file, 2026-11-13]
mechanical/exports/parts/S03_HTD5M_60T_pulley_ENVELOPE.step
100.4 x 100.5 x 18.0 mm
