le3334515-tech/open-elbow-exoskeleton/mechanical/exports/parts/S17_AS5600_PCB_ENVELOPE.step

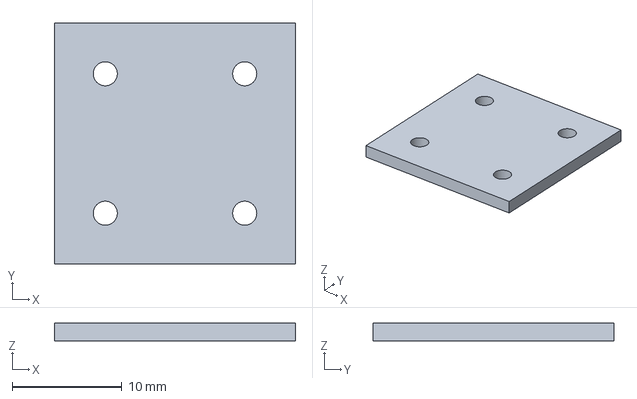
[picture p16: CAD file, 2026-11-13]
mechanical/exports/parts/S17_AS5600_PCB_ENVELOPE.step
22.0 x 22.0 x 1.60 mm
