le3334515-tech/open-elbow-exoskeleton/mechanical/exports/parts/S10_jackshaft_spacer_2.step

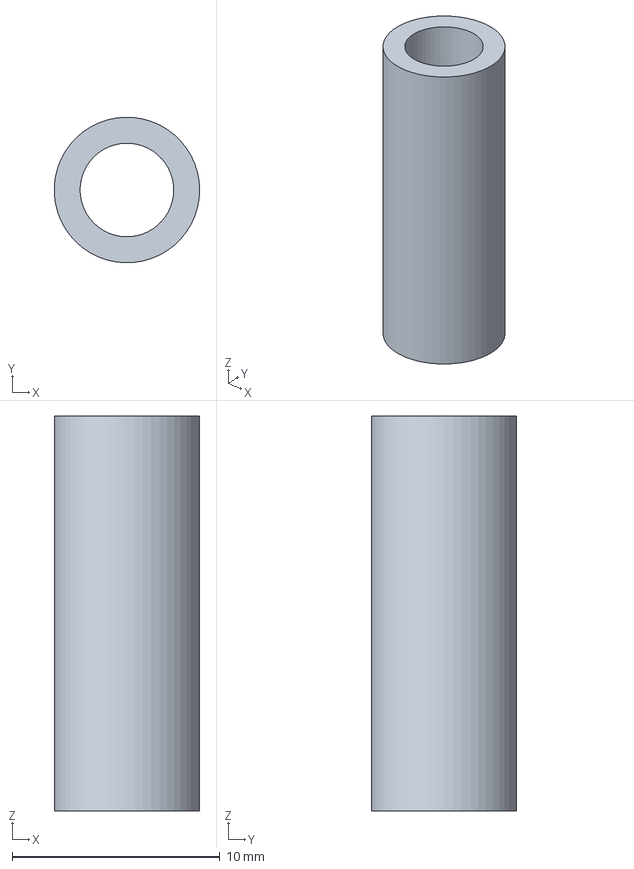
[picture p17: CAD file, 2026-11-13]
mechanical/exports/parts/S10_jackshaft_spacer_2.step
6.99 x 7.00 x 19.0 mm
