le3334515-tech/open-elbow-exoskeleton/mechanical/exports/parts/S02_bearing_6001_upper.step

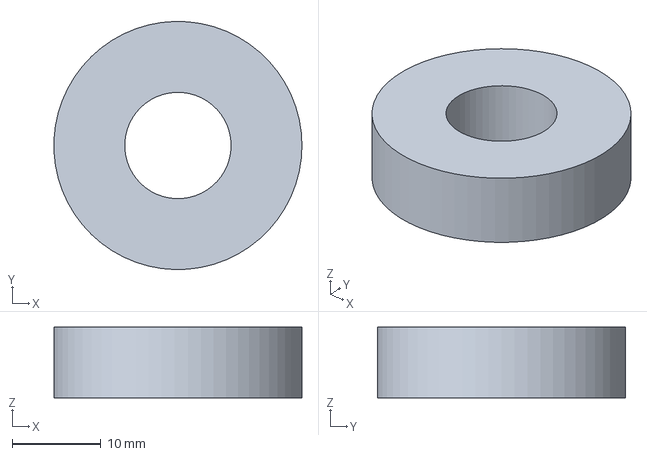
[picture p18: CAD file, 2026-11-13]
mechanical/exports/parts/S02_bearing_6001_upper.step
28.0 x 28.0 x 8.00 mm
