le3334515-tech/open-elbow-exoskeleton/mechanical/exports/parts/M13_upper_cuff_riser.step

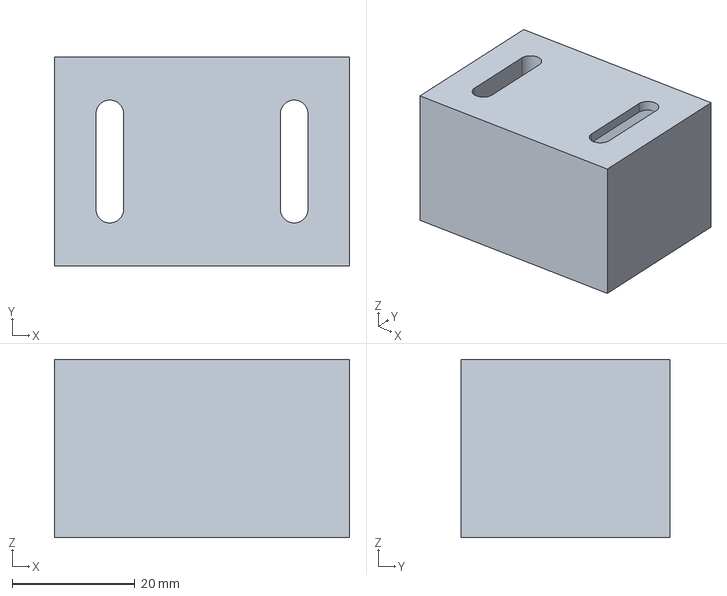
[picture p19: CAD file, 2026-11-13]
mechanical/exports/parts/M13_upper_cuff_riser.step
48.0 x 34.0 x 29.0 mm
