le3334515-tech/open-elbow-exoskeleton/mechanical/exports/parts/S04_rotating_stop_shoulder_pin.step

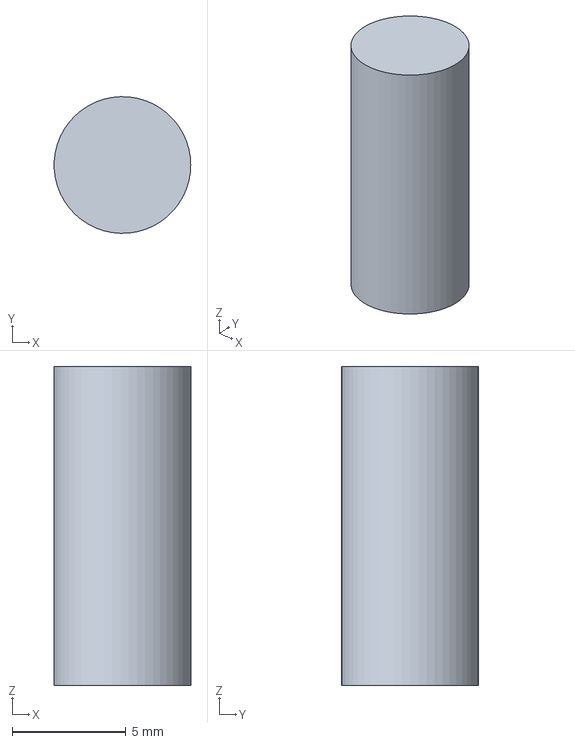
[picture p20: CAD file, 2026-11-13]
mechanical/exports/parts/S04_rotating_stop_shoulder_pin.step
5.99 x 6.00 x 14.0 mm
