le3334515-tech/open-elbow-exoskeleton/mechanical/exports/parts/S06_motor_standoff_2.step

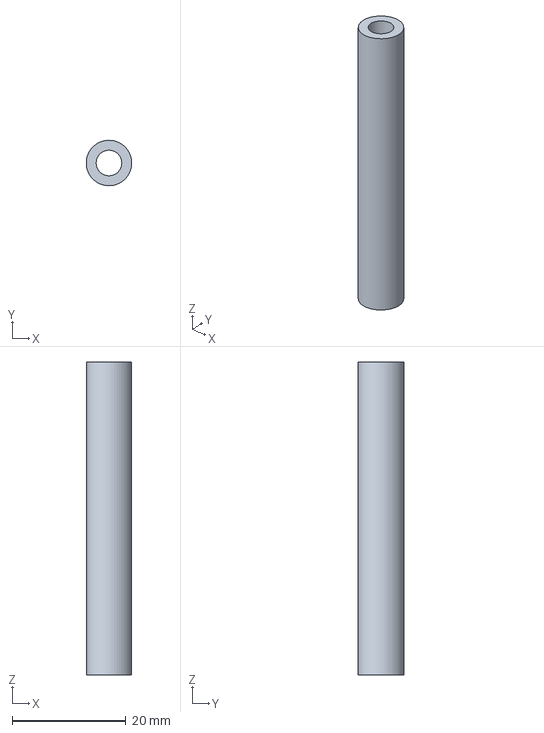
[picture p21: CAD file, 2026-11-13]
mechanical/exports/parts/S06_motor_standoff_2.step
7.99 x 8.00 x 55.0 mm
