le3334515-tech/open-elbow-exoskeleton/mechanical/exports/parts/S16_sensor_bridge_post_-25.step

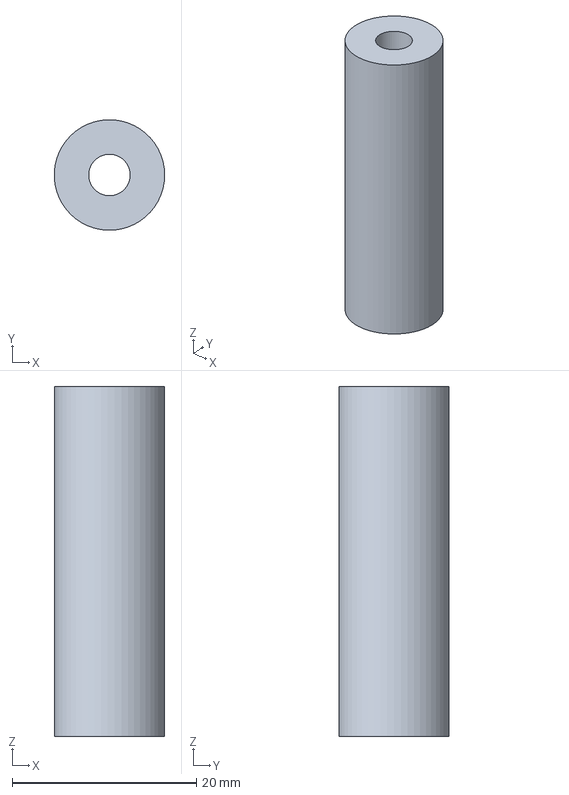
[picture p22: CAD file, 2026-11-13]
mechanical/exports/parts/S16_sensor_bridge_post_-25.step
12.0 x 12.0 x 38.0 mm
