le3334515-tech/open-elbow-exoskeleton/mechanical/exports/parts/M10_motor_jackshaft_6mm.step

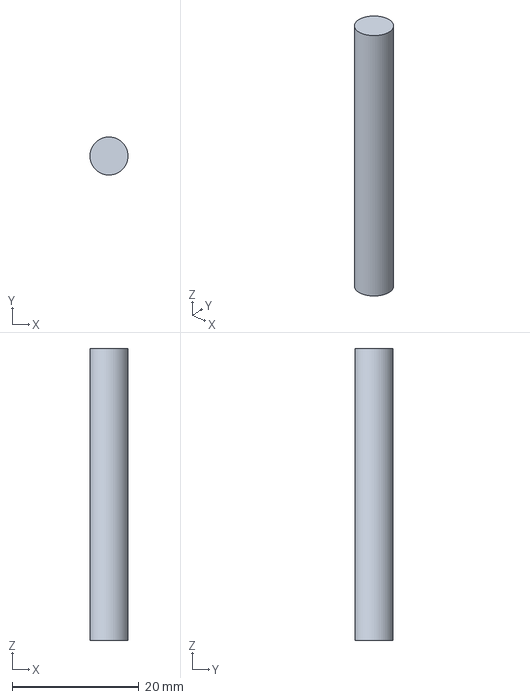
[picture p23: CAD file, 2026-11-13]
mechanical/exports/parts/M10_motor_jackshaft_6mm.step
5.99 x 6.00 x 46.0 mm
