le3334515-tech/open-elbow-exoskeleton/mechanical/exports/parts/M09_motor_front_adapter.step

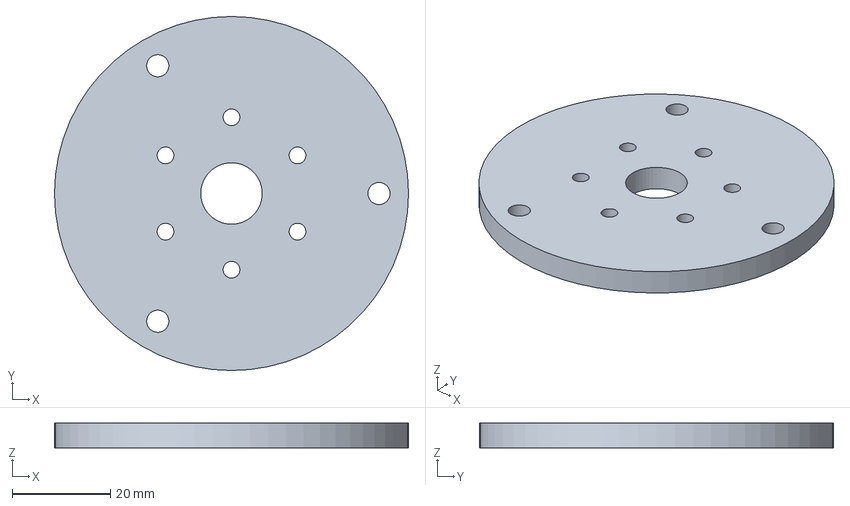
[picture p24: CAD file, 2026-11-13]
mechanical/exports/parts/M09_motor_front_adapter.step
72.0 x 72.0 x 5.00 mm
