le3334515-tech/open-elbow-exoskeleton/mechanical/exports/parts/S15_diametric_magnet_6x2.step

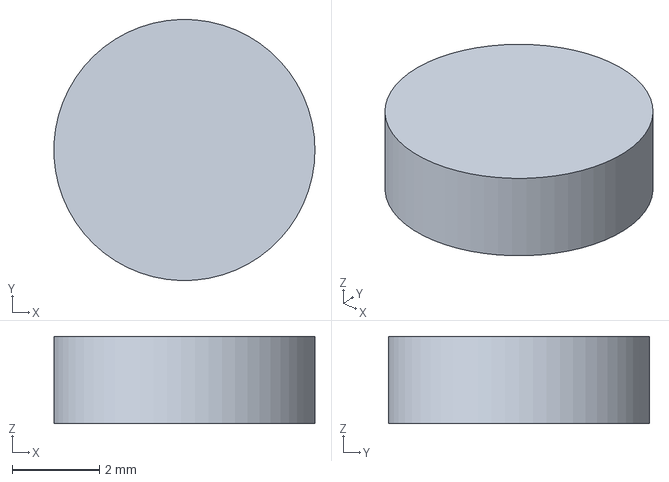
[picture p25: CAD file, 2026-11-13]
mechanical/exports/parts/S15_diametric_magnet_6x2.step
6.00 x 6.00 x 2.00 mm
