le3334515-tech/open-elbow-exoskeleton/mechanical/exports/parts/M05_pulley_clamp_hub.step

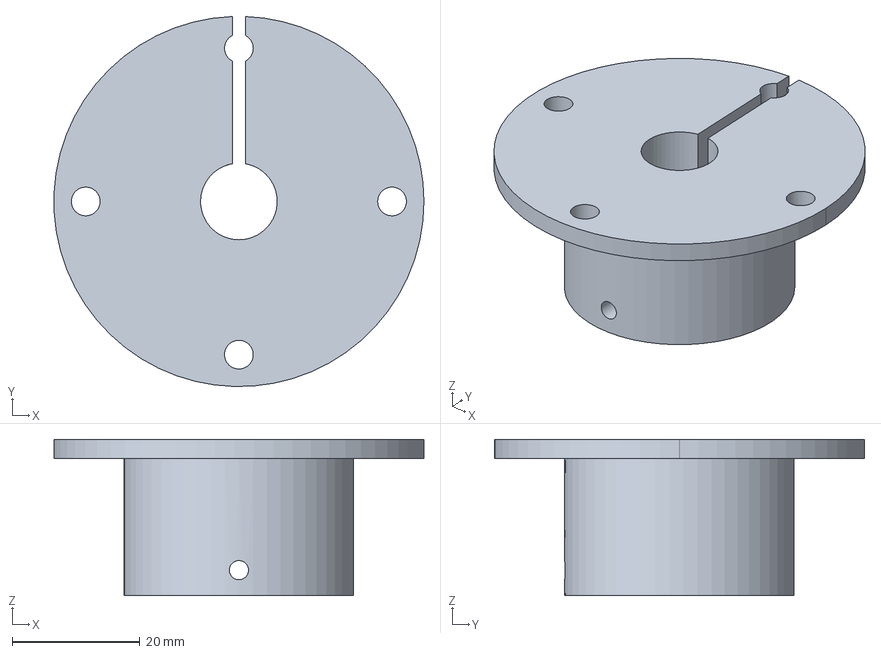
[picture p26: CAD file, 2026-11-13]
mechanical/exports/parts/M05_pulley_clamp_hub.step
58.0 x 58.0 x 24.5 mm
