le3334515-tech/open-elbow-exoskeleton/mechanical/exports/parts/S13_upper_cuff_quick_pin.step

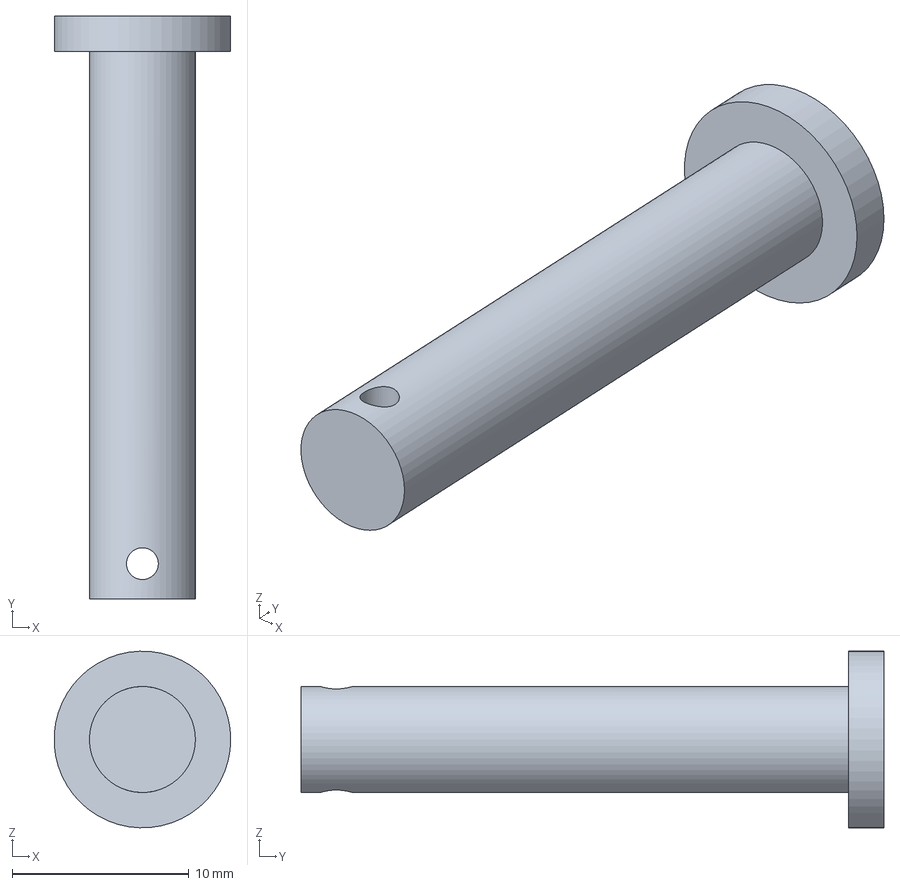
[picture p27: CAD file, 2026-11-13]
mechanical/exports/parts/S13_upper_cuff_quick_pin.step
9.99 x 33.0 x 10.00 mm
