le3334515-tech/open-elbow-exoskeleton/mechanical/exports/parts/S18_lower_shaft_collar_ENVELOPE.step

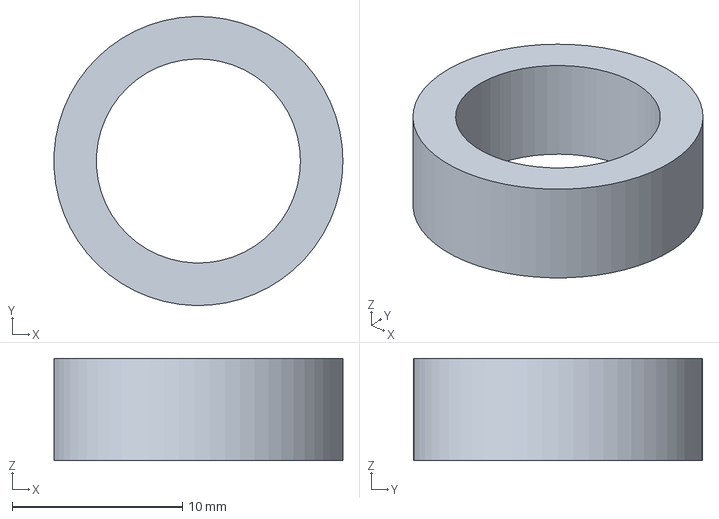
[picture p28: CAD file, 2026-11-13]
mechanical/exports/parts/S18_lower_shaft_collar_ENVELOPE.step
17.0 x 17.0 x 6.00 mm
