le3334515-tech/open-elbow-exoskeleton/mechanical/exports/parts/S08_flexible_coupler_6x6_ENVELOPE.step

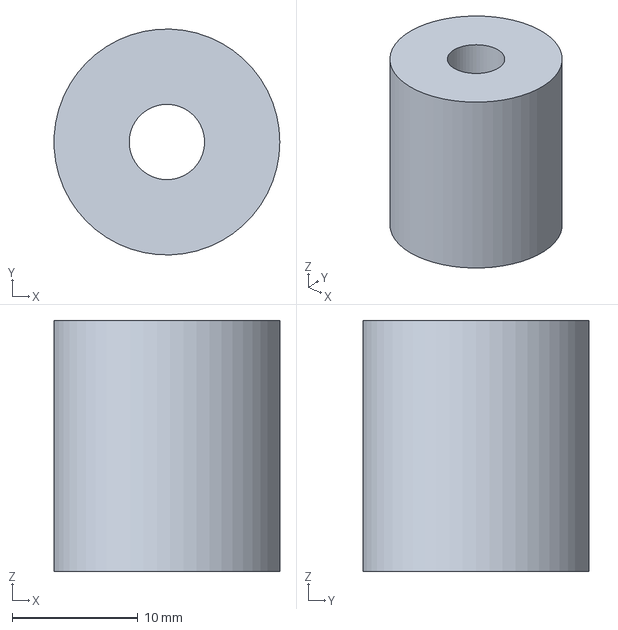
[picture p29: CAD file, 2026-11-13]
mechanical/exports/parts/S08_flexible_coupler_6x6_ENVELOPE.step
18.0 x 18.0 x 20.0 mm
