le3334515-tech/open-elbow-exoskeleton/mechanical/exports/parts/S19_upper_shaft_spacer.step

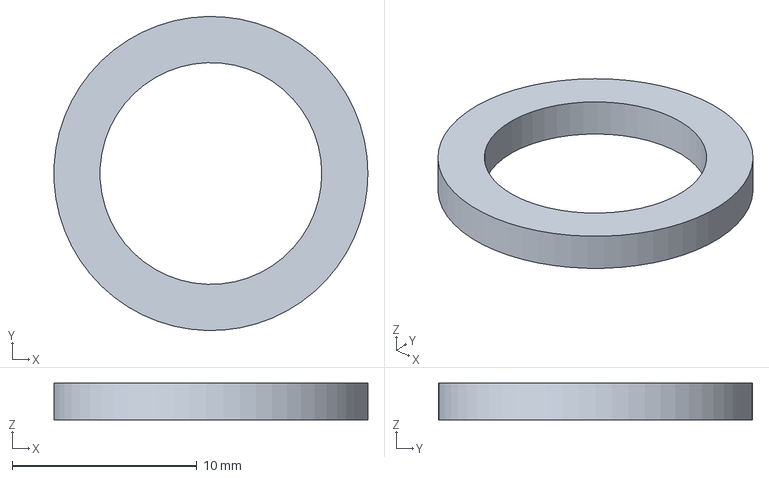
[picture p30: CAD file, 2026-11-13]
mechanical/exports/parts/S19_upper_shaft_spacer.step
17.0 x 17.0 x 2.00 mm
