le3334515-tech/open-elbow-exoskeleton/mechanical/exports/parts/M12_belt_guard.step

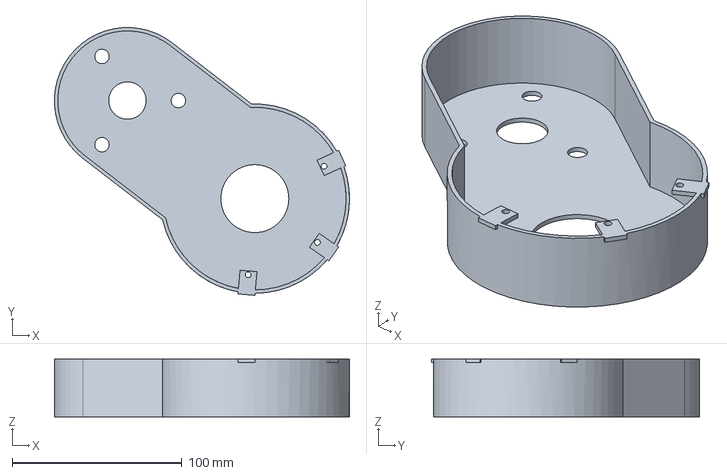
[picture p31: CAD file, 2026-11-13]
mechanical/exports/parts/M12_belt_guard.step
173.7 x 157.6 x 34.0 mm
