le3334515-tech/open-elbow-exoskeleton/mechanical/exports/parts/S12_HTD5M_400_15_belt_ENVELOPE.step

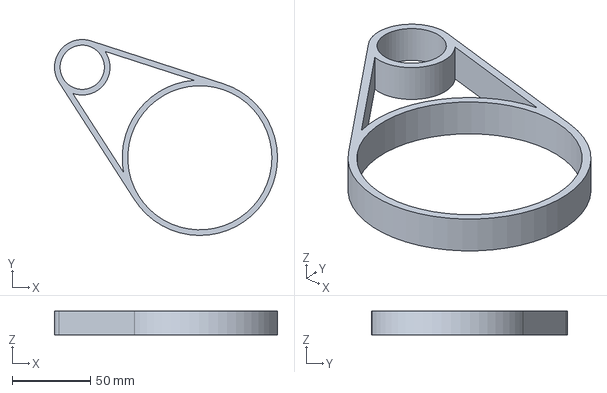
[picture p32: CAD file, 2026-11-13]
mechanical/exports/parts/S12_HTD5M_400_15_belt_ENVELOPE.step
142.2 x 125.0 x 15.0 mm
