le3334515-tech/open-elbow-exoskeleton/mechanical/exports/parts/M03_joint_bearing_housing.step

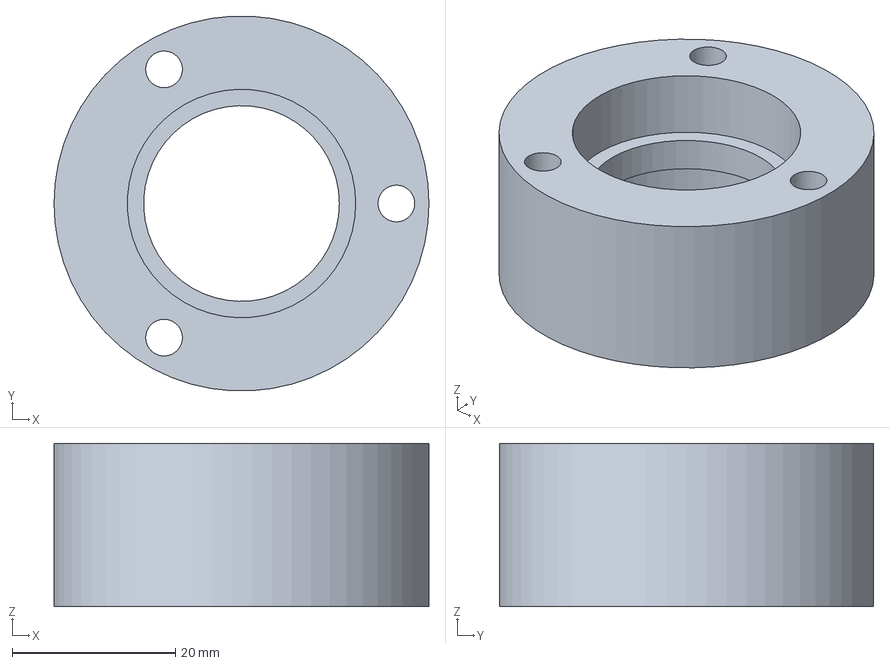
[picture p33: CAD file, 2026-11-13]
mechanical/exports/parts/M03_joint_bearing_housing.step
46.0 x 45.9 x 20.0 mm
