le3334515-tech/open-elbow-exoskeleton/mechanical/exports/parts/S11_HTD5M_20T_pulley_ENVELOPE.step

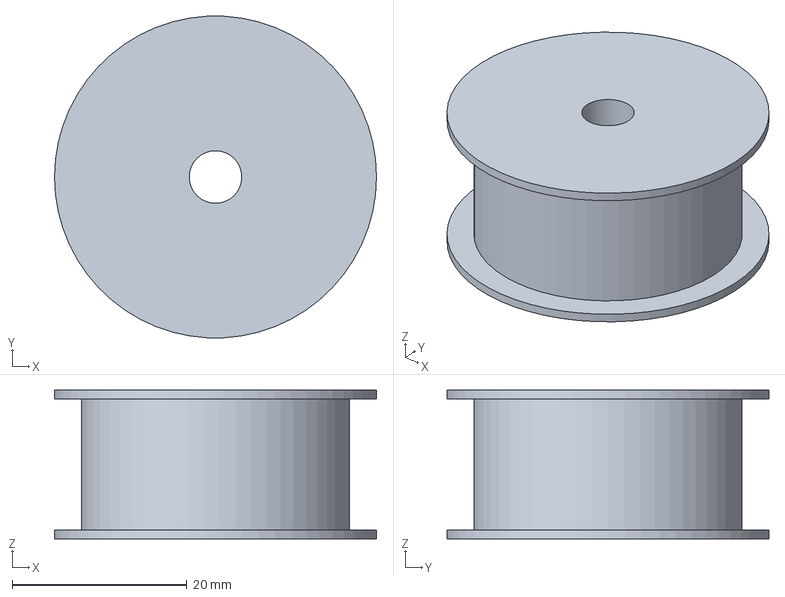
[picture p34: CAD file, 2026-11-13]
mechanical/exports/parts/S11_HTD5M_20T_pulley_ENVELOPE.step
36.8 x 36.8 x 17.0 mm
