le3334515-tech/open-elbow-exoskeleton/mechanical/exports/parts/M06_forearm_rotating_plate.step

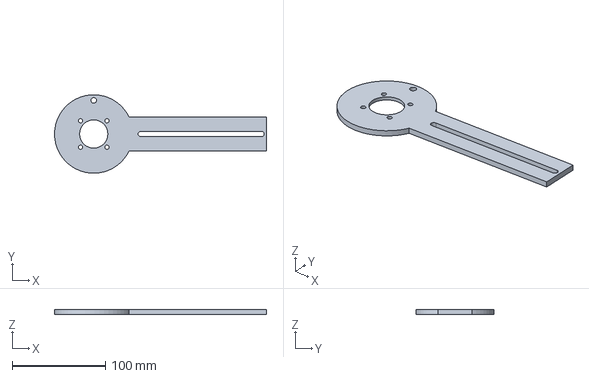
[picture p35: CAD file, 2026-11-13]
mechanical/exports/parts/M06_forearm_rotating_plate.step
227.0 x 84.0 x 5.00 mm
