le3334515-tech/open-elbow-exoskeleton/mechanical/exports/parts/M04_joint_shaft_12mm.step

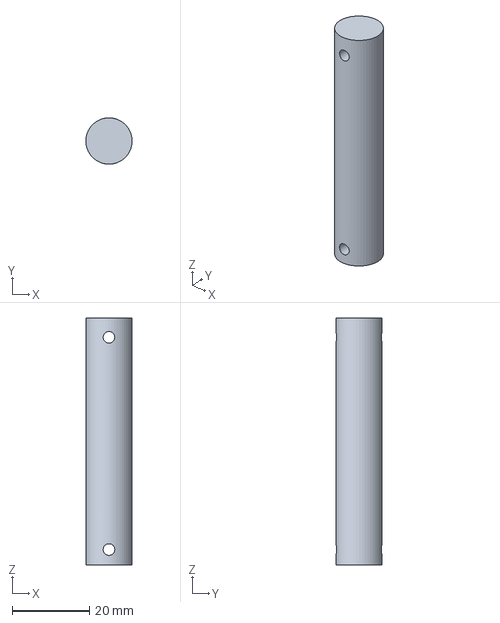
[picture p36: CAD file, 2026-11-13]
mechanical/exports/parts/M04_joint_shaft_12mm.step
12.0 x 12.0 x 64.0 mm
