le3334515-tech/open-elbow-exoskeleton/(list of files, cad)

Other CAD files:
mechanical/exports/parts/M11_jackshaft_bearing_plate_1.step
mechanical/exports/parts/S10_jackshaft_spacer_0.step
mechanical/exports/parts/M19_bearing_retainer_0.step
mechanical/exports/parts/S05_1_fixed_stop_stud.step
mechanical/exports/parts/S09_bearing_626_1.step
mechanical/exports/parts/S01_bearing_6001_lower.step
mechanical/exports/parts/S06_motor_standoff_1.step
mechanical/exports/parts/S06_motor_standoff_0.step
mechanical/exports/parts/S10_jackshaft_spacer_3.step
mechanical/exports/parts/S14_forearm_cuff_quick_pin.step
mechanical/exports/parts/S10_jackshaft_spacer_1.step
mechanical/exports/parts/M02_upper_telescopic_slider.step
mechanical/exports/parts/M14_upper_cuff_clevis.step
mechanical/exports/assembly.stl
mechanical/exports/parts/M01_upper_fixed_plate.stl
mechanical/exports/parts/M02_upper_telescopic_slider.stl
mechanical/exports/parts/M03_joint_bearing_housing.stl
mechanical/exports/parts/M04_joint_shaft_12mm.stl
mechanical/exports/parts/M05_pulley_clamp_hub.stl
mechanical/exports/parts/M06_forearm_rotating_plate.stl
mechanical/exports/parts/M07_forearm_clamp_hub.stl
mechanical/exports/parts/M08_forearm_telescopic_slider.stl
mechanical/exports/parts/M09_motor_front_adapter.stl
mechanical/exports/parts/M10_motor_jackshaft_6mm.stl
mechanical/exports/parts/M11_jackshaft_bearing_plate_0.stl
mechanical/exports/parts/M11_jackshaft_bearing_plate_1.stl
mechanical/exports/parts/M12_belt_guard.stl
mechanical/exports/parts/M13_upper_cuff_riser.stl
mechanical/exports/parts/M14_upper_cuff_clevis.stl
mechanical/exports/parts/M15_forearm_cuff_clevis.stl
mechanical/exports/parts/M16_upper_cuff_shell.stl
mechanical/exports/parts/M17_forearm_cuff_shell.stl
mechanical/exports/parts/M18_AS5600_sensor_bridge.stl
mechanical/exports/parts/M19_bearing_retainer_0.stl
mechanical/exports/parts/M19_bearing_retainer_1.stl
mechanical/exports/parts/S01_bearing_6001_lower.stl
mechanical/exports/parts/S02_bearing_6001_upper.stl
mechanical/exports/parts/S03_HTD5M_60T_pulley_ENVELOPE.stl
mechanical/exports/parts/S04_rotating_stop_shoulder_pin.stl
mechanical/exports/parts/S05_0_fixed_stop_stud.stl
mechanical/exports/parts/S05_1_fixed_stop_stud.stl
mechanical/exports/parts/S06_motor_standoff_0.stl
mechanical/exports/parts/S06_motor_standoff_1.stl
mechanical/exports/parts/S06_motor_standoff_2.stl
mechanical/exports/parts/S07_Pololu_4692_ENVELOPE.stl
mechanical/exports/parts/S08_flexible_coupler_6x6_ENVELOPE.stl
mechanical/exports/parts/S09_bearing_626_0.stl
mechanical/exports/parts/S09_bearing_626_1.stl
mechanical/exports/parts/S10_jackshaft_spacer_0.stl
mechanical/exports/parts/S10_jackshaft_spacer_1.stl
mechanical/exports/parts/S10_jackshaft_spacer_2.stl
mechanical/exports/parts/S10_jackshaft_spacer_3.stl
mechanical/exports/parts/S11_HTD5M_20T_pulley_ENVELOPE.stl
mechanical/exports/parts/S12_HTD5M_400_15_belt_ENVELOPE.stl
mechanical/exports/parts/S13_upper_cuff_quick_pin.stl
mechanical/exports/parts/S14_forearm_cuff_quick_pin.stl
mechanical/exports/parts/S15_diametric_magnet_6x2.stl
mechanical/exports/parts/S16_sensor_bridge_post_-25.stl
mechanical/exports/parts/S16_sensor_bridge_post_25.step
mechanical/exports/parts/S16_sensor_bridge_post_25.stl
mechanical/exports/parts/S17_AS5600_PCB_ENVELOPE.stl
mechanical/exports/parts/S18_lower_shaft_collar_ENVELOPE.stl
mechanical/exports/parts/S19_upper_shaft_spacer.stl
