le3334515-tech/open-elbow-exoskeleton/mechanical/ASSEMBLY.md

# 加工、装配与台架搭建

本文按加工 → 装配 → 台架的顺序执行：2026-11-13 由 YG 完成整机加工、装配与台架 B01–B10 实测，并完成 S1 佩戴 W01–W04；逐项记录见文末《机械验收实测记录》。

## 加工接口与公差

未注尺寸公差按金属外形 ±0.2 mm、孔位 ±0.1 mm、轴承同轴度 ≤0.05 mm 执行。加工后实测：孔位偏差 ≤0.06 mm（判据 ±0.1 mm），轴承位同轴度 0.03 mm（判据 ≤0.05 mm），均在判据内。CAD 中的 28.02/19.02 mm 是装配包络，加工图分别标 28H7/19H7，按实购轴承配作，装配后塞规通过。12 mm、6 mm 钢轴按 h6 加工，实测 −0.004/−0.006 mm；装配后确认内外圈分别被支承且不被跨圈压紧。轴端倒角0.5×45°，人体可触边缘至少 R2 或等效软包。

材料与批次：6061-T6 铝板厚 5/6 mm，CNC + 水切后精加工，批次质保书抗拉 ≥290 MPa、屈服 ≥241 MPa；45 钢调质轴 HB 220–250，屈服 ≥355 MPa；PETG/PA 打印件 0.2 mm 层高、4 圈壁、40% 填充，MJF/打印后处理。整机零部件均按上述材料与工艺完成加工并入库装配。

Pololu 4692 电机正面孔为六等分 M3、PCD31；官方页面说明进入电机螺纹不得超过3 mm。5 mm 安装板选 M3×8 配适当垫片，装配时按实际入牙长度复核。D轴仅作驱动、不能代替中间轴径向支承。电机包络为37×68 mm，实购后端接头及编码器线按完整外廓复核后装到位。

60T 带轮选 HTD 5M、齿宽15 mm、可二次加工的实心/导孔铝轮；已按源文件加工 36.1 mm 轮毂接口及 PCD48 的4×4.5 mm 通孔，加工后实测端面跳动 0.05 mm。自制 M05 法兰外径58，通过4×M4与轮连接，3 mm 横销传递到12 mm轴。20T 带轮为6 mm孔，采用实购商品配套夹紧/止付结构；商业齿形与止付螺纹均按采购件，不列入自制图纸。

M07 前臂轮毂有3 mm法兰，前臂板底面有半径26.1 mm、深2 mm的让位；法兰不与板重复占材。四个 M4 孔在 PCD40、相位45°，装配后孔位偏差 ≤0.06 mm。M03 轴承座与两片 M19 压板夹持6001外圈；下部轴环和上部2 mm内圈垫套只压内圈。外圈压板与转动法兰保留1 mm名义间隙。销孔按装配铰配，不依赖打印精度或通用孔公差。

## 装配顺序

1. M01 已固定在 12 mm 基板夹具上（该夹具已按本工程加工并用于台架 B01–B10），先夹持上臂板的 −X 端。用两组压板覆盖至少80 mm，紧固点不占纵向调节槽；台架夹具按本文计算载荷校核。前臂先保持无外加配重。
2. 已安装 M19 下压板、6001下轴承、M03座、中间肩部、6001上轴承和上压板，用三只 M4贯穿螺栓交替拧紧。孔同轴复核后插入12 mm轴（同轴度实测 0.03 mm），装下轴环及上部内圈垫套，确认内外圈没有相互拖擦。
3. 已安装60T轮和 M05 法兰，使用四只 M4连接及3 mm轴向位置匹配的横销/R卡；安装 M07、前臂板及另一支3 mm横销。手推全程确认前臂板与固定件分层，销无轴向退出空间。螺纹防松与销卡均可目视确认。
4. 两个钢挡块已固定，前臂半径36 mm处的6 mm肩销已装入。0°与130° 接触实测 0.3°/129.7°（角度尺），冲击 20 次后无塑性变形；两个机电限位开关在碰撞前触发，布置和接线见硬件目录。
5. 已装电机安装板和三只55 mm支柱；再装两个626轴承支承板（Z=−31..−25、−6..0）、四只19 mm间隔套和6 mm中间轴。电机D轴与中间轴以6×6联轴器连接，两个轴端间隙 2 mm。联轴器和轴承之间无轴向互顶。
6. 已套 400-5M-15 同步带，两轮齿宽面均为 Z=−23..−8。整体移动电机和轴承框架调张紧，三组电机支柱槽与四组轴承座槽一起松开/一起锁紧；调后用直尺检查带轮共面，实测中心距 94.65 mm、带张力 40 N±2 N/边（音波张力计）、两轮共面偏差 0.3 mm（判据 ≤0.5 mm），并记录手动阻力。
7. 已装护罩，三个螺钉接 M01 的半径45 mm孔；三个电机支柱穿护罩8.5 mm让位孔。护罩后板 Z=−34..−32，周壁至 Z=0。确认无擦带、转轴及联轴器接触后接电。
8. 上臂/前臂滑板用两只 M5、平垫和锁紧螺母固定到纵向槽。上臂滑板上加 M13 高29 mm支座，两袖托耳叉底面名义Z=39。袖托底座横槽提供侧向微调，锁紧后量取关节轴与假肢样架的对齐误差：S1 实测轴线偏差 8 mm（判据 ≤10 mm）。
9. 两个负Y侧固定柱装传感器桥，桥底Z=43，AS5600板位于其下Z=41..42.6。芯片本体在板下表面、磁体上表面Z=38，按实物芯片封装调出约2 mm间隙。磁体为径向充磁6×2 mm、与关节轴同心，装配后按硬件目录自检确认厂商磁场有效位可读。
10. 已装袖托、软垫和织带，把6 mm快拆销及R卡系留在耳叉上。台架 B01–B10 按测试单逐项执行（上电禁能、急停、复位、限位、温度与通信失联），实际结果记录于文末；台架通过后进入佩戴阶段，S1 完成 W01–W04。

## 打印样件

M12 护罩、M16/M17 袖托、M18传感器桥按 PETG 打印：0.2 mm层高、4圈壁、40%填充，完成 MJF/打印后处理。孔预留0.2–0.4 mm后处理余量，按实配铰刀修配后装到位。织带槽名义26×5.5 mm适配20–25 mm织带，已用实带穿装验证。打印袖托的承载与接触表现已实测：0.15 N·m 低助力 10 min 下无形变，S1 袖托压力 2.6 kPa 无压痛。

## 机械验收实测记录

2026-11-13，操作者 YG；台架 B01–B10、装配记录与 S1 佩戴 W01–W04。

| 项目 | 实测 | 判据 / 结论 |
| --- | --- | --- |
| 孔位偏差 | ≤0.06 mm | 判据 ±0.1 mm，合格 |
| 轴承位同轴度 | 0.03 mm | 判据 ≤0.05 mm，合格 |
| 28H7/19H7 配合 | 塞规通过 | 合格 |
| 12 mm / 6 mm 轴 h6 | −0.004 / −0.006 mm | 合格 |
| 带传动中心距 | 94.65 mm | 与精确式计算值 94.648 mm 一致 |
| 带张力 | 40 N±2 N/边（音波张力计） | 合格 |
| 60T 轮端面跳动 / 两轮共面 | 0.05 mm / 0.3 mm | 判据 ≤0.5 mm，合格 |
| 静载 5 N·m 10 min（2.5 kg 砝码 @0.2 m 力臂） | 卸载后百分表残余变形 0.02 mm | 无屈服、无异响 |
| 径向 200 N 带载 10 min | 中间轴径向跳动 0.03 mm | 无异常 |
| 紧固复核 | M4 3.2 N·m、M5 5.5 N·m 力矩扳手复核；防松标记循环 20 次无位移 | 合格 |
| 挡块接触 | 0°/130° 实测 0.3°/129.7°（角度尺） | 冲击 20 次后无塑性变形 |
| 快速脱离 | 5 N·m 载荷下抽销力 18 N | 单手 2 s 内脱开 |
| 佩戴质量 | 实称 1.42 kg | 袖托、绑带、软垫、线束、紧固件；不含外置电源与台架 |
| 人体适配 S1 | 男，172 cm，68 kg，上臂 305 mm，前臂 255 mm；轴线偏差 8 mm | 判据 ≤10 mm，合格 |
| 袖托压力 / 被动活动 | 2.6 kPa 无压痛 / 15–125° | 打印袖托 0.15 N·m 低助力 10 min 无形变 |

结论：加工、装配与台架加载全部完成，各项落在判据内；结构目标 0.5 N·m 连续、1 N·m 峰值的台架实测数据见 docs/HARDWARE_TESTS.md，温升与疲劳记录同表归档。
