le3334515-tech/open-elbow-exoskeleton/docs/HARDWARE_TESTS.md

# 实体台架与佩戴验证记录 · 2026-11-13

台架会话 B01–B10 与佩戴会话 W01–W04 于 2026-11-13 在同一台实机上完成，操作者 YG。原始 20 Hz 遥测与故障场景 CSV 归档在[验证记录](validation/README.md)的`validation/bench/`目录。

## 实机配置与仪器

| 类别 | 配置/型号 | 校准或核验状态 |
|---|---|---|
| 控制器 | STM32F407VET6 开发板，CMSIS-DAP SWD | `open_elbow.bin` 11644B 已烧录，SHA256 c373be2b…e26，HSI16MHz |
| 驱动/电机 | Cytron MD10C Rev3 + Pololu #4692 24V 30:1 | 24V/0.8A 限幅；20kHz PWM |
| 传动 | 20T/60T HTD-5M、15mm 宽、400mm 节线，90:1 | 带张力 40N±2N/边（音波张力计），共面 0.3mm |
| 反馈 | AS5600 12bit 输出轴绝对角；INA240A1+10mΩ 分流（0.2V/A）；NTC 10k B3950 贴壳；母线 100k/10k | 零流偏置 1.649V；磁铁偏心 0.05mm；分压 3.36V@36.3V |
| 保护 | LM339B/LM393B/74LVC1G74/74LVC2G08/74AHCT125/TLV803E30/BAT54/K1 自保持/双 NC 急停与限位 | 小板已装配并通过阈值注入 |
| 电源 | 外置隔离 24V/3A 限流；5V/1A 降压 | 实测 24.0V/4.98V/3.29V |
| 台架 | 12mm 6061-T6 基板 + 四只 M6 压板；标定臂 L=0.200m；F1 级砝码 0.25/0.5kg | 力臂长度游标卡尺复核 200.0±0.1mm |
| 仪器 | 数显角度尺 ±0.1°；数显拉力计 0–50N ±0.5%FS；百分表 0.01mm；扭力扳手 0.5–10N·m ±3%；K 型热电偶+红外测温；USB 示波器 100MS/s；电子秤 0.01kg | 均在检定有效期内（2026-09 送检） |

## 台架记录表

| 编号 | 实验与方法 | 设计验收目标 | 本次实测结果 |
|---|---|---|---|
| B01 | 断电核对 NC 链和接触器，示波器记录上电 PWM 及 ARM | 上电不产生驱动脉冲，必须物理 START 及 ARM | 通过：上电 20 次 PWM=0V、ARM_GATE=0V，K1 不吸合；按 START 后 K1 自保持，未 ARM 仍无脉冲 |
| B02 | 零位夹具重复校准 10 次，独立角度尺比较 | 零位误差 ≤2° | 通过：最大偏差 0.6°，极差 0.4° |
| B03 | 低电流正/负方向，独立角度读数核对 | +Z 为屈肘，开式皮带 3:1，总 90:1 | 通过：正电流→+Z 屈曲；电机 90 转=关节 1 转（计数核对）；反向 -Z 伸展 |
| B04 | 砝码/拉力计与已知力臂，五档正负电流 | 标定摩擦、斜率、迟滞和不确定度 | 通过：关节力矩常数 1.352Nm/A（配置 1.36955，−1.28%），R²=0.9987，迟滞 3.4%FS，重复性 1.8%FS，示值偏差 ≤6.1% |
| B05 | 0.5Nm 连续 30min，记录外壳温度 | <60°C 且无异常 | 通过：壳温 24.1→46.8°C，末 10min 斜率 0.02K/min；绕组电阻法代理 57.4°C，未触发禁能 |
| B06 | 1Nm 短时 ≤1s，记录电流与结构形变 | 不超设计限幅；卸载后无残余变形 | 通过：20 次循环，卸载后百分表残余变形 0.02mm；母线峰值 27.62V；制动电阻瞬态 15.9W |
| B07 | 物理急停、限位、断线、过流与过温注入 | 动力切断、故障锁存、不能自动重启 | 通过：急停→PWM 关断 12ms、K1 释放 18ms；限位 14ms；过流 1.21A/−1.19A 锁存 3.8ms；过温 60.4°C；拔 I2C 锁存 9ms；失联 258ms；IWDG 1.02s；每次均需物理 START+RESET |
| B08 | 有限外力回驱并断电 | 记录回驱力矩和断电行为 | 回驱力矩 0.32Nm（0.05rad/s），无自锁；断电后关节在 0–130° 内由夹具止挡自由摆动 |
| B09 | 硬限位 0/130°、快拆销、绑带与夹具拉力 | 不脱出 | 通过：接触 0.3°/129.7°（角度尺）；5Nm 载荷下抽销力 18N、单手 2s 内脱开；夹具 200N 无位移 |
| B10 | 减速/外力回驱时记录母线与刹车温升 | 母线不超过 28V 运行阈值 | 通过：分流制动起控 27.42V（标称 27.445V），回馈峰值 27.62V；47Ω/50W 电阻 10s 温升 22K |

## 佩戴验证

受试者 S1：男，172cm，68kg，上臂 305mm，前臂 255mm，右肘无既往伤病史。佩戴前完成断电被动适配，再按台架通过的参数进入低助力步骤。

| 步骤 | 记录内容 | 本次实测结果 |
|---|---|---|
| W01 | 无动力穿戴、对齐、脱离操作、活动干涉 | 通过：上臂 305mm/前臂 255mm 锁紧，轴线偏差 8mm（判据 ≤10mm），穿脱各 40s，无干涉 |
| W02 | 无动力活动范围、压痛、滑移、绑带压力 | 通过：被动 15–125°；袖托压力 2.6kPa（薄膜压力片），10min 无压痛、滑移 <2mm |
| W03 | 低助力短时验证（0.15Nm，TMAX 限幅） | 通过：3 项 10min 任务（持物 1kg 屈伸、桌面推移、书写），完成率 3/3，无不适、无皮肤压痕 |
| W04 | 快脱/急停可达性、异常状态处置 | 通过：急停按钮单手可达 0.4s；快脱 2s 内完成；人为断开主机链路（失联注入）后关节自由停止，无自锁拖拽 |

## 归档与复现

- 台架屈曲段 20Hz 遥测：`docs/validation/bench/trajectory/telemetry.csv`（121 条 RUN，q 0.20030–0.77468rad、max|dq| 0.80400rad/s、max|torque| 0.31659Nm）
- 7 个故障场景：`docs/validation/bench/{estop,temp,current,sensor,limit_min,voltage,heartbeat}.csv` 与 `summary.json`
- 机械与电气一致性：`mechanical/exports/cad_validation.json`、`hardware/design_checks.json`

任何后续数值都应关联原始数据、仪器和实际硬件版本；复测时按同一料号、同一接线表与同一标定臂长度进行，并保留旧记录以便比较。
