le3334515-tech/open-elbow-exoskeleton/docs/validation/bench/current.csv

time_ms | state | fault | q | dq | current | temperature | voltage | torque | enabled
50 | STANDBY | NONE | 0.0 | 0.0 | 0.0 | 25.0 | 24.0 | 0.0 | False
100 | STANDBY | NONE | 0.0 | 0.0 | 0.0 | 25.0 | 24.0 | 0.0 | False
150 | STANDBY | NONE | 0.0 | 0.0 | 0.0 | 25.0 | 24.0 | 0.0 | False
200 | CALIBRATING | NONE | 0.0 | 0.0 | 0.0 | 25.0 | 24.0 | 0.0 | False
250 | CALIBRATING | NONE | 0.0 | 0.0 | 0.0 | 25.0 | 24.0 | 0.0 | False
300 | STANDBY | NONE | 0.0 | 0.0 | 0.0 | 25.0 | 24.0 | 0.0 | False
350 | STANDBY | NONE | 0.0 | 0.0 | 0.0 | 25.0 | 24.0 | 0.0 | False
400 | STANDBY | NONE | 0.22453 | 0.0 | 0.0 | 25.0 | 24.0 | 0.0 | False
450 | RUN | NONE | 0.22442 | -0.01873 | 0.0 | 25.0 | 24.0 | 0.0 | True
500 | RUN | NONE | 0.22158 | -0.08692 | 0.01398 | 25.0 | 24.0 | 0.03831 | True
550 | RUN | NONE | 0.21625 | -0.12055 | 0.02985 | 25.0 | 24.0 | 0.07205 | True
600 | RUN | NONE | 0.21003 | -0.12286 | 0.04797 | 25.0 | 24.0 | 0.10659 | True
650 | RUN | NONE | 0.20445 | -0.09637 | 0.06713 | 25.0 | 24.0 | 0.13977 | True
700 | FAULT | CURRENT | 0.20384 | 0.0 | 1.4 | 25.0 | 24.0 | 0.0 | False
