le3334515-tech/open-elbow-exoskeleton/docs/validation/bench/estop.csv

time_ms | state | fault | q | dq | current | temperature | voltage | torque | enabled
50 | STANDBY | NONE | 0.0 | 0.0 | 0.0 | 25.0 | 24.0 | 0.0 | False
100 | STANDBY | NONE | 0.0 | 0.0 | 0.0 | 25.0 | 24.0 | 0.0 | False
150 | STANDBY | NONE | 0.0 | 0.0 | 0.0 | 25.0 | 24.0 | 0.0 | False
200 | CALIBRATING | NONE | 0.0 | 0.0 | 0.0 | 25.0 | 24.0 | 0.0 | False
250 | CALIBRATING | NONE | 0.0 | 0.0 | 0.0 | 25.0 | 24.0 | 0.0 | False
300 | STANDBY | NONE | 0.0 | 0.0 | 0.0 | 25.0 | 24.0 | 0.0 | False
350 | STANDBY | NONE | 0.0 | 0.0 | 0.0 | 25.0 | 24.0 | 0.0 | False
400 | STANDBY | NONE | 0.22453 | 0.0 | 0.0 | 25.0 | 24.0 | 0.0 | False
450 | RUN | NONE | 0.2239 | -0.04474 | 0.0 | 25.0 | 24.0 | 0.0 | True
500 | RUN | NONE | 0.21976 | -0.1169 | 0.0 | 25.0 | 24.0 | 0.0 | True
550 | RUN | NONE | 0.21247 | -0.16296 | 0.03026 | 25.0 | 24.0 | 0.08193 | True
600 | RUN | NONE | 0.20433 | -0.15836 | 0.04565 | 25.0 | 24.0 | 0.10549 | True
650 | RUN | NONE | 0.19705 | -0.12985 | 0.06137 | 25.0 | 24.0 | 0.12897 | True
700 | RUN | NONE | 0.19172 | -0.08137 | 0.07708 | 25.0 | 24.0 | 0.15157 | True
750 | ESTOP | ESTOP | 0.19034 | 0.0 | 0.0001 | 25.0 | 24.0 | 0.0 | False
