le3334515-tech/open-elbow-exoskeleton/docs/validation/bench/heartbeat.csv

time_ms | state | fault | q | dq | current | temperature | voltage | torque | enabled
50 | STANDBY | NONE | 0.0 | 0.0 | 0.0 | 25.0 | 24.0 | 0.0 | False
100 | STANDBY | NONE | 0.0 | 0.0 | 0.0 | 25.0 | 24.0 | 0.0 | False
150 | STANDBY | NONE | 0.0 | 0.0 | 0.0 | 25.0 | 24.0 | 0.0 | False
200 | CALIBRATING | NONE | 0.0 | 0.0 | 0.0 | 25.0 | 24.0 | 0.0 | False
250 | CALIBRATING | NONE | 0.0 | 0.0 | 0.0 | 25.0 | 24.0 | 0.0 | False
300 | STANDBY | NONE | 0.0 | 0.0 | 0.0 | 25.0 | 24.0 | 0.0 | False
350 | STANDBY | NONE | 0.0 | 0.0 | 0.0 | 25.0 | 24.0 | 0.0 | False
400 | STANDBY | NONE | 0.22453 | 0.0 | 0.0 | 25.0 | 24.0 | 0.0 | False
450 | RUN | NONE | 0.22442 | -0.01873 | 0.0 | 25.0 | 24.0 | 0.0 | True
500 | RUN | NONE | 0.22147 | -0.09528 | 0.0 | 25.0 | 24.0 | 0.0 | True
550 | RUN | NONE | 0.21513 | -0.14798 | 0.02606 | 25.0 | 24.0 | 0.07129 | True
600 | RUN | NONE | 0.2075 | -0.15265 | 0.04146 | 25.0 | 24.0 | 0.09688 | True
650 | RUN | NONE | 0.2003 | -0.13175 | 0.05762 | 25.0 | 24.0 | 0.12267 | True
700 | RUN | NONE | 0.19472 | -0.08888 | 0.07401 | 25.0 | 24.0 | 0.14752 | True
750 | FAULT | HEARTBEAT | 0.19437 | 0.0 | 0.0 | 25.0 | 24.0 | 0.0 | False
