le3334515-tech/open-elbow-exoskeleton/docs/validation/bench/limit_min.csv

time_ms | state | fault | q | dq | current | temperature | voltage | torque | enabled
50 | STANDBY | NONE | 0.0 | 0.0 | 0.0 | 25.0 | 24.0 | 0.0 | False
100 | STANDBY | NONE | 0.0 | 0.0 | 0.0 | 25.0 | 24.0 | 0.0 | False
150 | STANDBY | NONE | 0.0 | 0.0 | 0.0 | 25.0 | 24.0 | 0.0 | False
200 | CALIBRATING | NONE | 0.0 | 0.0 | 0.0 | 25.0 | 24.0 | 0.0 | False
250 | CALIBRATING | NONE | 0.0 | 0.0 | 0.0 | 25.0 | 24.0 | 0.0 | False
300 | STANDBY | NONE | 0.0 | 0.0 | 0.0 | 25.0 | 24.0 | 0.0 | False
350 | STANDBY | NONE | 0.0 | 0.0 | 0.0 | 25.0 | 24.0 | 0.0 | False
400 | STANDBY | NONE | 0.22453 | 0.0 | 0.0 | 25.0 | 24.0 | 0.0 | False
450 | RUN | NONE | 0.2244 | -0.0204 | 0.0 | 25.0 | 24.0 | 0.0 | True
500 | RUN | NONE | 0.22138 | -0.09667 | 0.0 | 25.0 | 24.0 | 0.0 | True
550 | RUN | NONE | 0.21521 | -0.13892 | 0.02704 | 25.0 | 24.0 | 0.06979 | True
600 | RUN | NONE | 0.20803 | -0.14345 | 0.04289 | 25.0 | 24.0 | 0.09784 | True
650 | RUN | NONE | 0.20131 | -0.12175 | 0.05973 | 25.0 | 24.0 | 0.12578 | True
700 | RUN | NONE | 0.19627 | -0.07736 | 0.07686 | 25.0 | 24.0 | 0.15243 | True
750 | FAULT | LIMIT | 0.19597 | 0.0 | 0.0 | 25.0 | 24.0 | 0.0 | False
