le3334515-tech/open-elbow-exoskeleton/docs/validation/bench/temp.csv

time_ms | state | fault | q | dq | current | temperature | voltage | torque | enabled
50 | STANDBY | NONE | 0.0 | 0.0 | 0.0 | 25.0 | 24.0 | 0.0 | False
100 | STANDBY | NONE | 0.0 | 0.0 | 0.0 | 25.0 | 24.0 | 0.0 | False
150 | STANDBY | NONE | 0.0 | 0.0 | 0.0 | 25.0 | 24.0 | 0.0 | False
200 | CALIBRATING | NONE | 0.0 | 0.0 | 0.0 | 25.0 | 24.0 | 0.0 | False
250 | CALIBRATING | NONE | 0.0 | 0.0 | 0.0 | 25.0 | 24.0 | 0.0 | False
300 | STANDBY | NONE | 0.0 | 0.0 | 0.0 | 25.0 | 24.0 | 0.0 | False
350 | STANDBY | NONE | 0.0 | 0.0 | 0.0 | 25.0 | 24.0 | 0.0 | False
400 | STANDBY | NONE | 0.22453 | 0.0 | 0.0 | 25.0 | 24.0 | 0.0 | False
450 | RUN | NONE | 0.2244 | -0.0204 | 0.0 | 25.0 | 24.0 | 0.0 | True
500 | RUN | NONE | 0.22138 | -0.09667 | 0.0 | 25.0 | 24.0 | 0.0 | True
550 | RUN | NONE | 0.21498 | -0.14835 | 0.02637 | 25.0 | 24.0 | 0.07179 | True
600 | RUN | NONE | 0.20734 | -0.15247 | 0.04178 | 25.0 | 24.0 | 0.0974 | True
650 | RUN | NONE | 0.20017 | -0.1311 | 0.05795 | 25.0 | 24.0 | 0.12318 | True
700 | RUN | NONE | 0.19463 | -0.08783 | 0.07434 | 25.0 | 24.0 | 0.148 | True
750 | FAULT | TEMPERATURE | 0.19311 | 0.0 | 0.0001 | 65.0 | 24.0 | 0.0 | False
