le3334515-tech/open-elbow-exoskeleton/docs/validation/bench/trajectory/telemetry.csv

time_ms | state | fault | q | dq | current | temperature | voltage | torque | enabled
50 | STANDBY | NONE | 0.0 | 0.0 | 0.0 | 25.0 | 24.0 | 0.0 | False
100 | STANDBY | NONE | 0.0 | 0.0 | 0.0 | 25.0 | 24.0 | 0.0 | False
150 | STANDBY | NONE | 0.0 | 0.0 | 0.0 | 25.0 | 24.0 | 0.0 | False
200 | CALIBRATING | NONE | 0.0 | 0.0 | 0.0 | 25.0 | 24.0 | 0.0 | False
250 | CALIBRATING | NONE | 0.0 | 0.0 | 0.0 | 25.0 | 24.0 | 0.0 | False
300 | STANDBY | NONE | 0.0 | 0.0 | 0.0 | 25.0 | 24.0 | 0.0 | False
350 | STANDBY | NONE | 0.0 | 0.0 | 0.0 | 25.0 | 24.0 | 0.0 | False
400 | STANDBY | NONE | 0.22453 | 0.0 | 0.0 | 25.0 | 24.0 | 0.0 | False
450 | RUN | NONE | 0.2239 | -0.04474 | 0.0 | 25.0 | 24.0 | 0.0 | True
500 | RUN | NONE | 0.22007 | -0.10116 | 0.01873 | 25.0 | 24.0 | 0.04885 | True
550 | RUN | NONE | 0.21428 | -0.12462 | 0.03546 | 25.0 | 24.0 | 0.08314 | True
600 | RUN | NONE | 0.20811 | -0.11734 | 0.05404 | 25.0 | 24.0 | 0.11743 | True
650 | RUN | NONE | 0.20303 | -0.08245 | 0.07333 | 25.0 | 24.0 | 0.14989 | True
700 | RUN | NONE | 0.2003 | -0.02445 | 0.0925 | 25.0 | 24.0 | 0.17954 | True
750 | RUN | NONE | 0.20095 | 0.05151 | 0.11104 | 25.0 | 24.0 | 0.20616 | True
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
