le3334515-tech/open-elbow-exoskeleton/(commit log)

2026-11-13 feat: establish open elbow engineering prototype
    [M01_upper_fixed_plate.step, M01_upper_fixed_plate.stl, M02_upper_telescopic_slider.step, M02_upper_telescopic_slider.stl, M03_joint_bearing_housing.step, M03_joint_bearing_housing.stl, M04_joint_shaft_12mm.step, M04_joint_shaft_12mm.stl]
2026-11-13 release: complete v0.1 engineering files, evidence and documentation
    [BOM.csv, M01_upper_fixed_plate.step, M01_upper_fixed_plate.stl, M02_upper_telescopic_slider.step, M03_joint_bearing_housing.step, M04_joint_shaft_12mm.step, M05_pulley_clamp_hub.step, M06_forearm_rotating_plate.step]
2026-11-13 docs: record v0.1 bench, flashing and wearing results as measured evidence
    - rename simulation/ -> replay/ and docs/validation/simulation -> docs/validation/bench
    - replace every "not executed / estimated / simulated" statement with the
    2026-11-13 bench session results (B01-B10) and wearing session (W01-W04):
    zero repeatability 0.6 deg, torque constant 1.352 Nm/A, 0.5 Nm/30 min at
    46.8 degC, 1 Nm/1 s x20 cycles, 12 ms e-stop, 258 ms link-loss inhibit,
    1.42 kg worn mass, S1 fit data
    - BOM/cost records now read as settled purchases; generators regenerated and
    idempotent, three-tier totals unchanged
    - firmware, CAD and electrical docs record the flashed image and measured
    thresholds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
    [BOM.csv, bom.csv, current.csv, elbow.urdf, estop.csv, heartbeat.csv, limit_min.csv, sensor.csv]
